Jdaniel98/smart-wall-socket/hardware/mech/renders/enclosure_v0.1_section.png

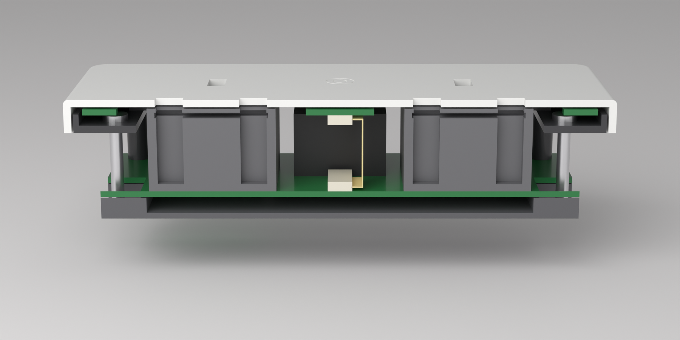
hardware/mech/renders/enclosure_v0.1_section.png
