Jdaniel98/smart-wall-socket/hardware/mech/concept/2_exploded.png

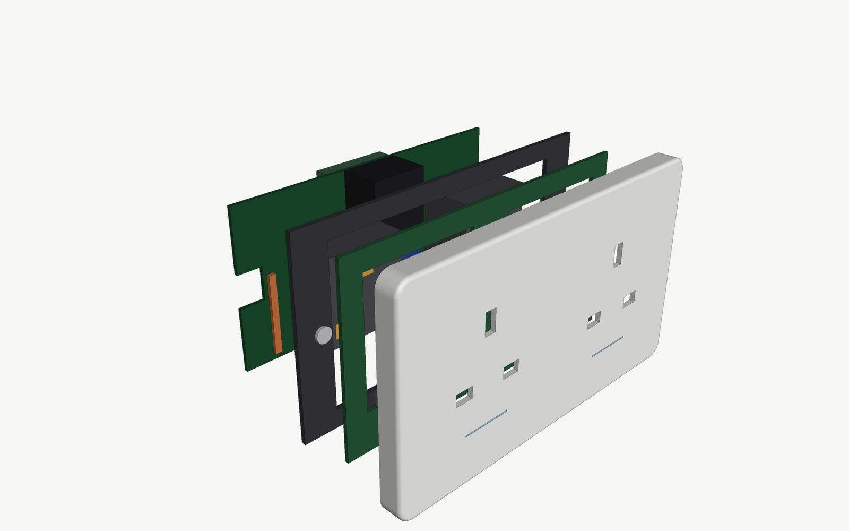
hardware/mech/concept/2_exploded.png
