Jdaniel98/smart-wall-socket/hardware/mech/concept/3_in_box.png

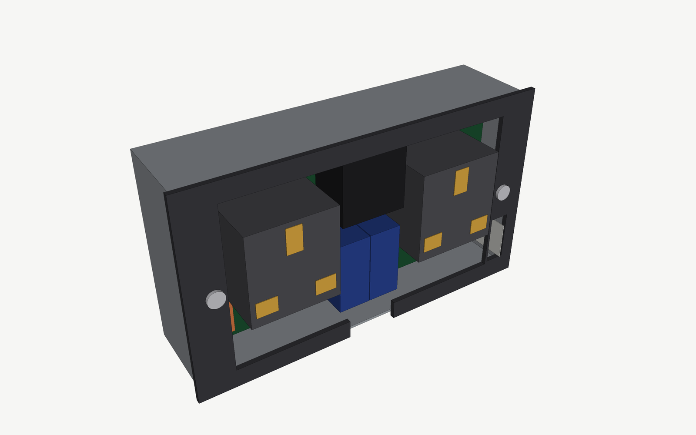
hardware/mech/concept/3_in_box.png
