Jdaniel98/smart-wall-socket/hardware/mech/concept/4_back.png

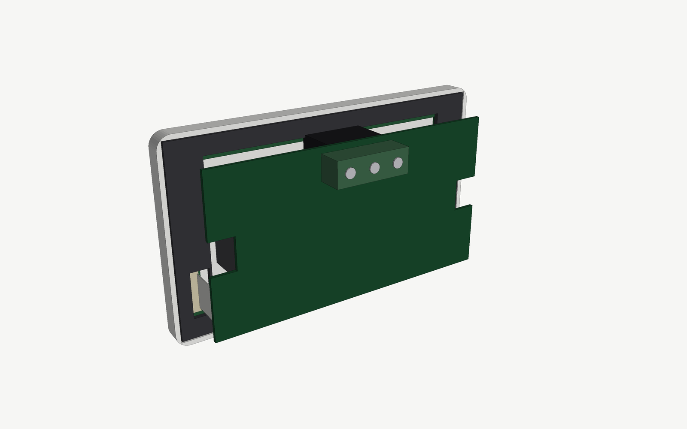
hardware/mech/concept/4_back.png
