Jdaniel98/smart-wall-socket/hardware/mech/concept/5_exploded_cycles.png

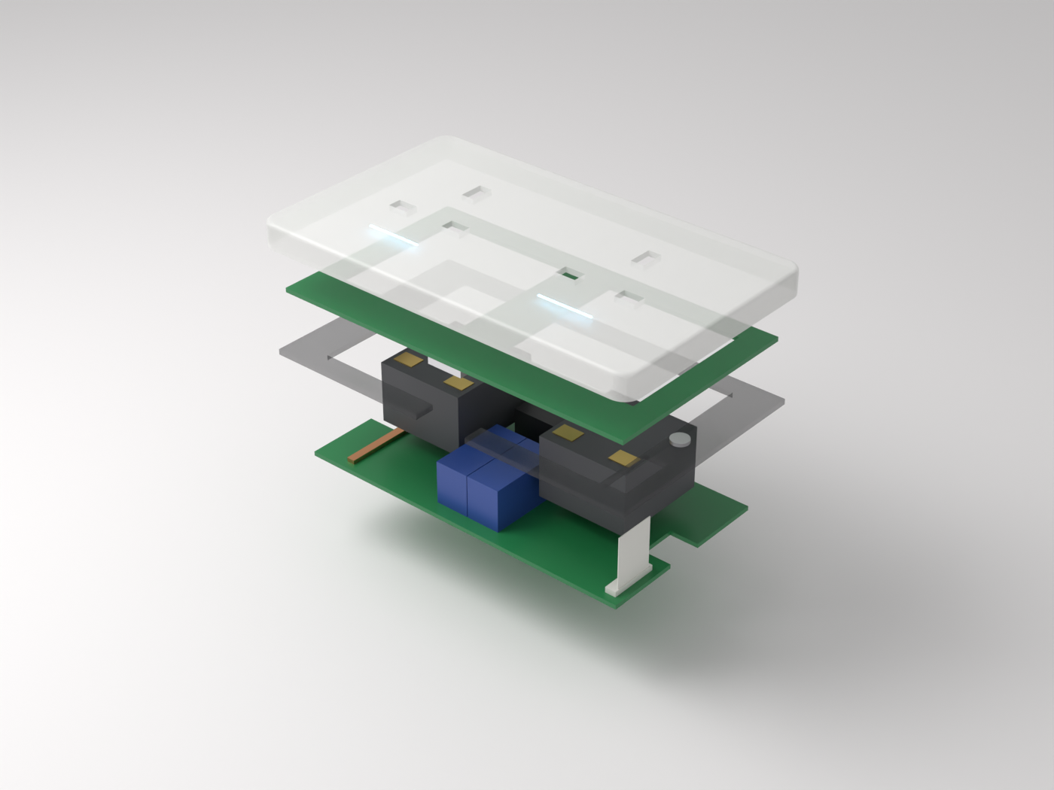
hardware/mech/concept/5_exploded_cycles.png
