Jdaniel98/smart-wall-socket/hardware/mech/concept/realistic/board.png

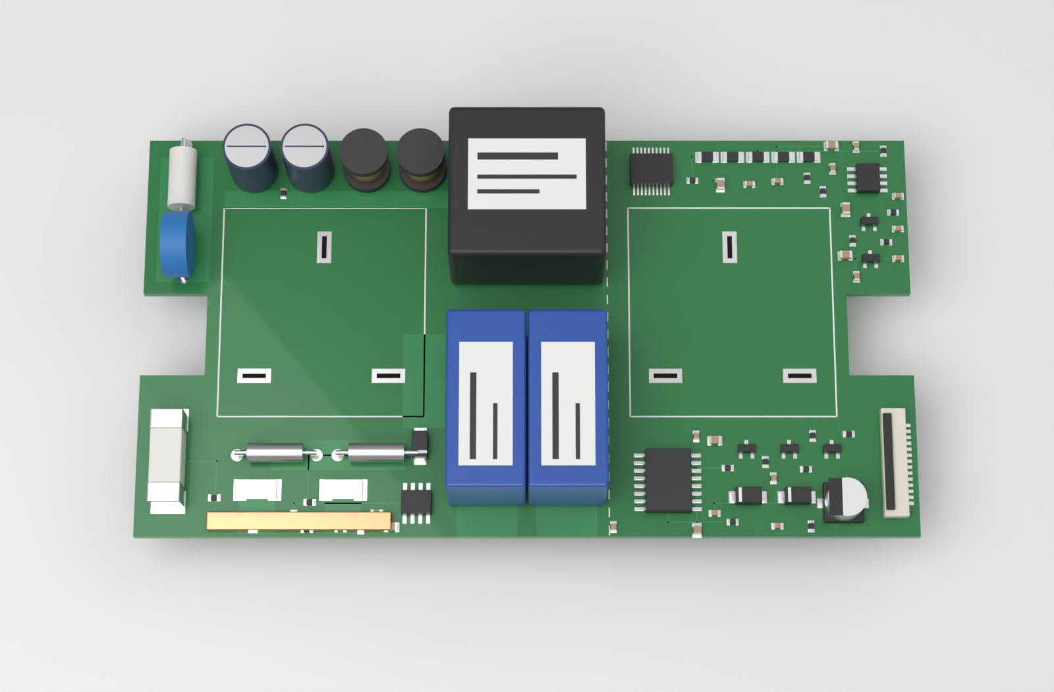
hardware/mech/concept/realistic/board.png
