Jdaniel98/smart-wall-socket/hardware/mech/concept/realistic/exploded.png

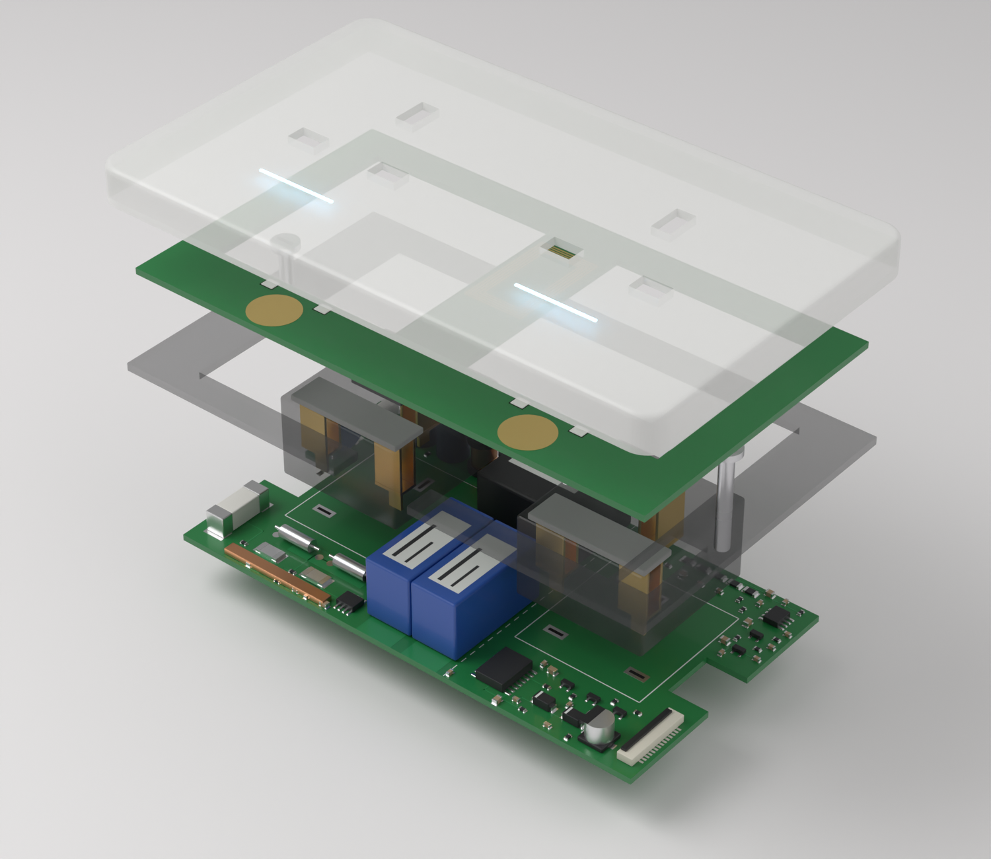
hardware/mech/concept/realistic/exploded.png
