Jdaniel98/smart-wall-socket/hardware/mech/concept/realistic/lineart.png

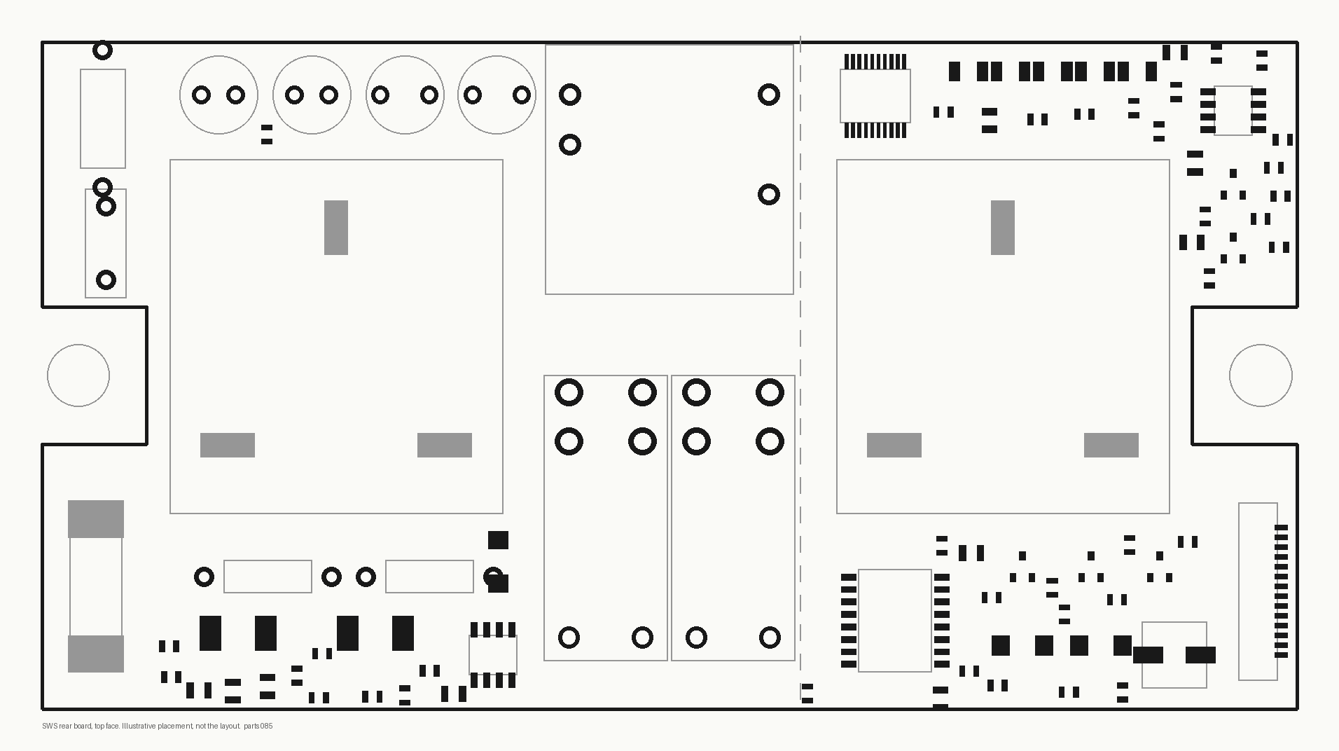
hardware/mech/concept/realistic/lineart.png
