Jdaniel98/smart-wall-socket/hardware/mech/renders/enclosure_v0.1_rear.png

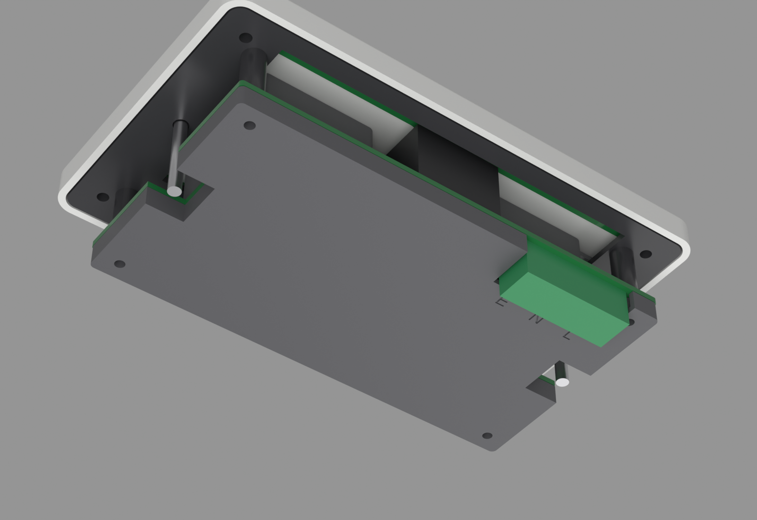
hardware/mech/renders/enclosure_v0.1_rear.png
