Jdaniel98/smart-wall-socket/hardware/mech/renders/outline_v0.1_front.png

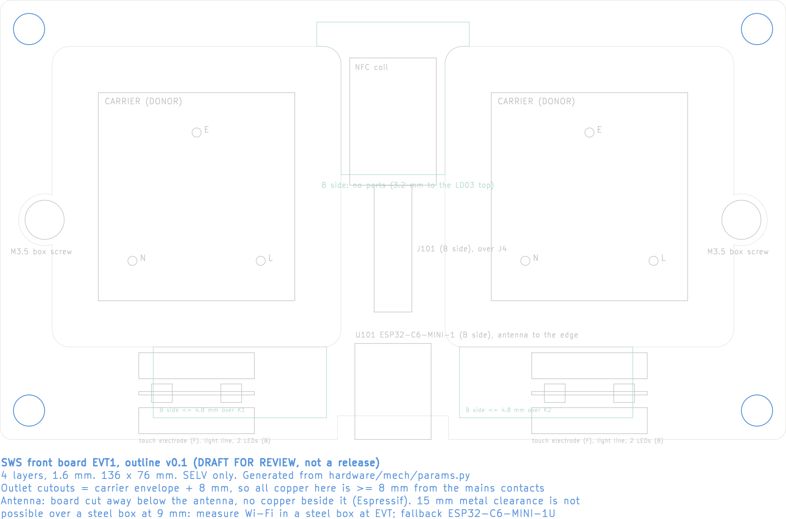
hardware/mech/renders/outline_v0.1_front.png
