Jdaniel98/smart-wall-socket/hardware/evt1/front/sws-front-bom-jlcpcb.csv

Comment | Designator | Footprint | LCSC Part #
22u 10V | C101,C104,C105 | C_0805_2012Metric | C45783
10u 10V | C102,C106,C118 | C_0805_2012Metric | C15850
100n | C107,C109,C110,C112,C114,C116,C117,C119,C120,C121,C122 | C_0603_1608Metric | C14663
1u | C108 | C_0603_1608Metric | C15849
10n C0G | C111,C113 | C_0603_1608Metric | C76599
FPC 14P 1.0mm bottom contact | J101 | TE_1-84952-4_1x14-1MP_P1.0mm_Horizontal | C574848
2.2uH 1.65A 45mR shielded | L101 | L_Bourns-SRN4018 | C340367
AO3401A | Q101 | SOT-23 | C15127
2N7002 | Q102 | SOT-23 | C8545
453k 1% | R101 | R_0603_1608Metric | C667826
100k 1% | R102 | R_0603_1608Metric | C25803
10k | R103,R104,R105,R116 | R_0603_1608Metric | C25804
10k 0.1% | R106,R107 | R_0603_1608Metric | C328421
4.7k | R108,R111,R114,R115 | R_0603_1608Metric | C23162
0R | R110,R113 | R_0603_1608Metric | C21189
33R | R117 | R_0603_1608Metric | C23140
100k | R118,R119 | R_0603_1608Metric | C25803
+5V | TP101 | TestPoint_Pad_D1.5mm
+3V3 | TP102 | TestPoint_Pad_D1.5mm
GND | TP103 | TestPoint_Pad_D1.5mm
EN | TP104 | TestPoint_Pad_D1.5mm
BOOT | TP105 | TestPoint_Pad_D1.5mm
U0TXD | TP106 | TestPoint_Pad_D1.5mm
U0RXD | TP107 | TestPoint_Pad_D1.5mm
USB_D+ | TP108 | TestPoint_Pad_D1.5mm
USB_D- | TP109 | TestPoint_Pad_D1.5mm
TLV62569DBVR | U101 | SOT-23-5 | C141836
AT42QT1011-TSHR | U103,U104 | SOT-23-6 | C112956
NT3H2111W0FTTJ | U105 | TSSOP-8_3x3mm_P0.65mm | C2654884
SN74AHCT1G125DBVR | U106 | SOT-23-5 | C7484
