Jdaniel98/smart-wall-socket/hardware/evt1/rear/sws-rear-bom-jlcpcb.csv

Comment | Designator | Footprint | LCSC Part #
4.7u 450V 105C 12000h | C1,C23 | CP_Radial_D8.0mm_P3.50mm | C22391567
10u 25V | C2,C5,C22,C25 | C_0805_2012Metric | C15850
100n | C3,C4,C11,C13,C14,C16 | C_0603_1608Metric | C14663
33n X7R | C6,C7,C8,C9,C10 | C_0603_1608Metric | C21117
1u | C15,C17,C20,C21,C27 | C_0603_1608Metric | C15849
1u 25V | C18 | C_0805_2012Metric | C116352
150u 10V 105C low ESR | C19 | CP_Elec_6.3x5.8 | C264054
1u 16V | C24 | C_0603_1608Metric | C15849
100u 16V 105C | C26 | CP_Elec_6.3x5.8 | C128532
M7 1000V 1A | D1,D8,D10 | D_SMA | C95872
BZT52C5V1 | D2 | D_SOD-123 | C2117
BAS116 | D3 | SOT-23 | C48502
SMBJ7.0A | D4 | D_SMB | C669050
SS14 | D5,D6 | D_SMA | C2480
ES1J 600V 35ns | D9 | D_SMA | C412438
FPC 14P 1.0mm bottom contact | J4 | TE_1-84952-4_1x14-1MP_P1.0mm_Horizontal | C574848
1mH 0.36A | L1,L2 | L_Radial_D8.7mm_P5.00mm_Fastron_07HCP | C72626
AO3400A | Q1,Q2 | SOT-23 | C20917
12R 3W wirewound | R1 | R_Axial_DIN0617_L17.0mm_D6.0mm_P20.32mm_Horizontal
47R 2W fusible wirewound | R2 | R_Axial_DIN0617_L17.0mm_D6.0mm_P20.32mm_Horizontal
1k | R3,R4,R5,R6,R13 | R_0603_1608Metric | C21190
390k 1% 1206 500V | R7,R8,R9,R10,R11 | R_1206_3216Metric | C307946
470R 1% | R12 | R_0603_1608Metric | C23179
10k | R14,R25,R26,R31,R32 | R_0603_1608Metric | C25804
2M VR37 3.5kV | R15,R16,R18,R19 | R_Axial_DIN0411_L9.9mm_D3.6mm_P12.70mm_Horizontal
47k 1% | R17,R20 | R_0603_1608Metric | C25819
470k 1% | R21 | R_0603_1608Metric | C23178
182k 1% | R22 | R_0603_1608Metric | C22894
100k 1% | R23 | R_0603_1608Metric | C25803
49.9k 1% | R24 | R_0603_1608Metric | C23184
100R | R27,R29 | R_0603_1608Metric | C22775
100k | R28,R30 | R_0603_1608Metric | C25803
3.09k 1% | R35 | R_0603_1608Metric | C843947
2.49k 0.5% | R36 | R_0603_1608Metric | C407609
1m 1% 5W metal element | RS1,RS2 | R_2512_6332Metric | C4175647
MOV 561K 10mm | RV1 | RV_Disc_D12mm_W4.2mm_P7.5mm | C3263770
10k B3950 1% | TH1,TH2 | R_0603_1608Metric | C47118797
LNK3204D | U1 | PowerIntegrations_SO-8C
BL0939 | U2 | SSOP-20_3.9x8.7mm_P0.635mm | C2841044
SN74LVC1G32DBVR | U3 | SOT-23-5 | C10096
LMV393IDR | U4 | SOIC-8_3.9x4.9mm_P1.27mm | C7984
ISO7761DWR | U5 | SOIC-16W_7.5x10.3mm_P1.27mm | C2871529
XC6206P332MR | U6,U7 | SOT-23 | C5446
