Jdaniel98/smart-wall-socket/hardware/mech/out/assembly_evt1_v0.1.step

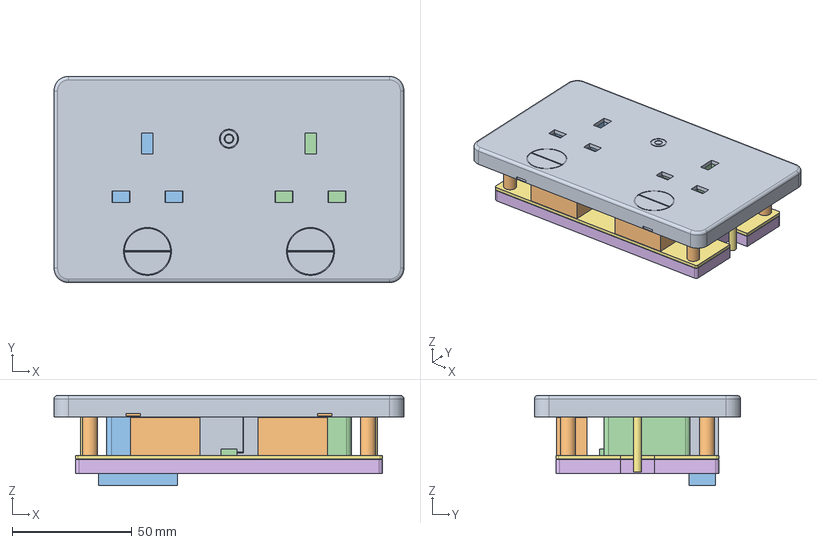
[picture p13: CAD file, 2026-11-11]
hardware/mech/out/assembly_evt1_v0.1.step
146.0 x 86.0 x 37.6 mm
