Jdaniel98/smart-wall-socket/hardware/mech/out/light_guide_right.step

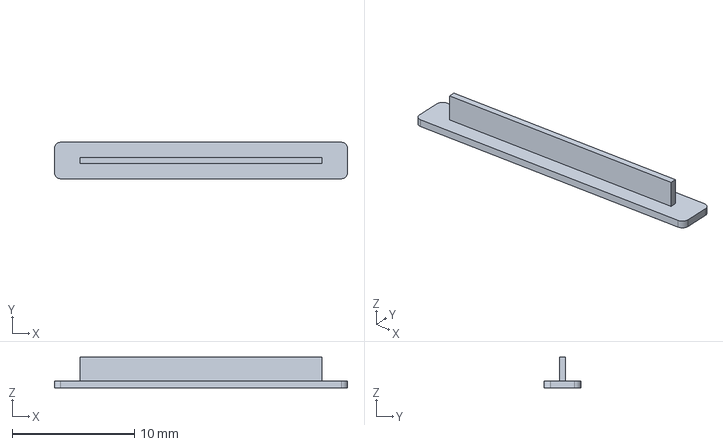
[picture p14: CAD file, 2026-11-11]
hardware/mech/out/light_guide_right.step
24.0 x 3.00 x 2.50 mm
