Jdaniel98/smart-wall-socket/hardware/mech/out/rear_cover.step

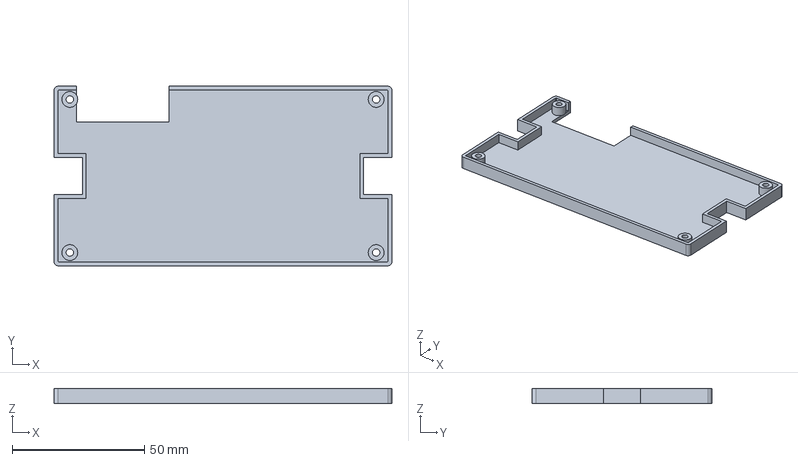
[picture p15: CAD file, 2026-11-11]
hardware/mech/out/rear_cover.step
128.0 x 68.0 x 5.80 mm
