Jdaniel98/smart-wall-socket/hardware/mech/out/carrier_right.step

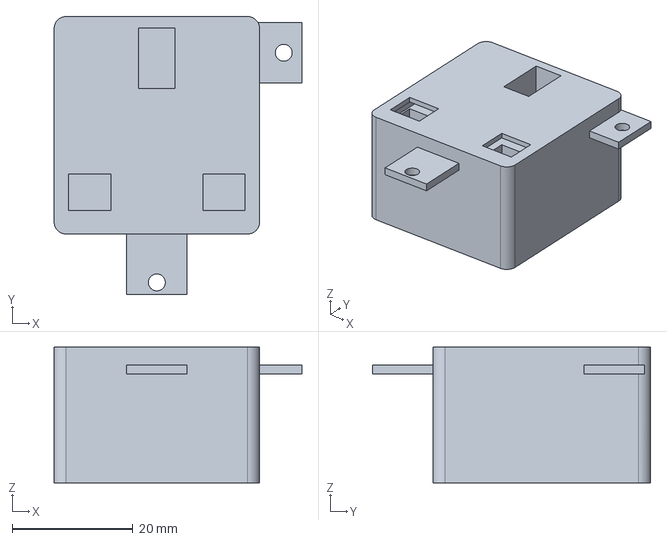
[picture p16: CAD file, 2026-11-11]
hardware/mech/out/carrier_right.step
41.0 x 46.0 x 22.5 mm
