Jdaniel98/smart-wall-socket/hardware/mech/out/faceplate.step

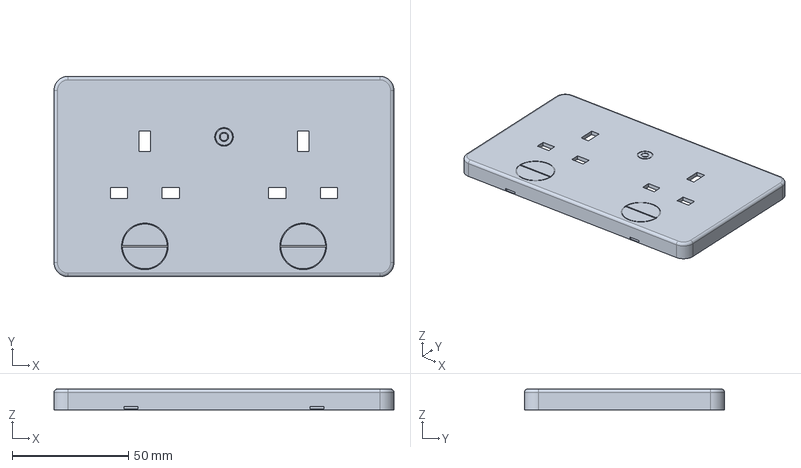
[picture p17: CAD file, 2026-11-11]
hardware/mech/out/faceplate.step
146.0 x 86.0 x 9.00 mm
