Jdaniel98/smart-wall-socket/hardware/mech/out/inner_frame.step

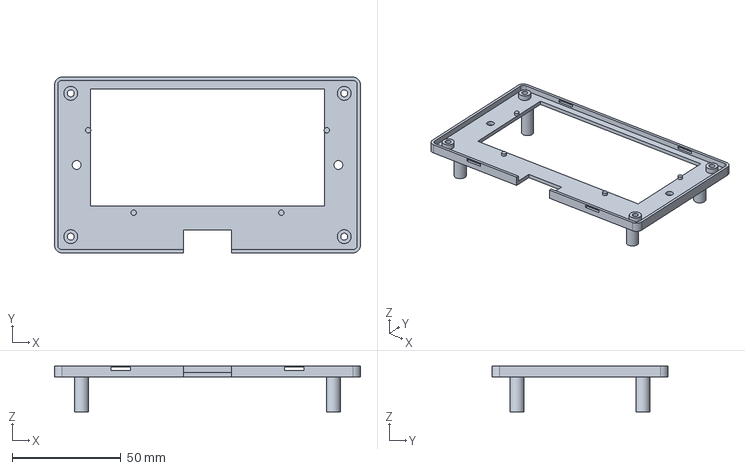
[picture p18: CAD file, 2026-11-11]
hardware/mech/out/inner_frame.step
141.0 x 81.0 x 21.0 mm
