Jdaniel98/smart-wall-socket/(list of files, cad)

Other CAD files:
hardware/mech/out/light_guide_left.step
hardware/mech/out/carrier_left.step
hardware/mech/out/carrier_left.stl
hardware/mech/out/carrier_right.stl
hardware/mech/out/faceplate.stl
hardware/mech/out/inner_frame.stl
hardware/mech/out/light_guide_left.stl
hardware/mech/out/light_guide_right.stl
hardware/mech/out/rear_cover.stl
