Jdaniel98/smart-wall-socket/hardware/mech/concept/1_assembled.png

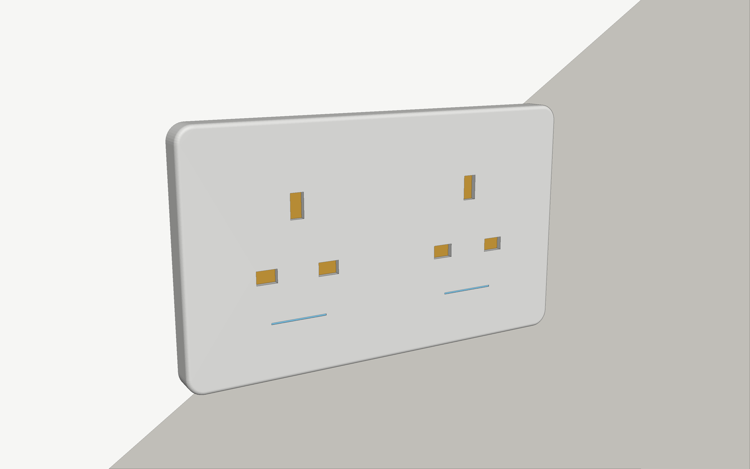
hardware/mech/concept/1_assembled.png
