Jdaniel98/smart-wall-socket/hardware/evt1/front/sws-front-schematic.pdf

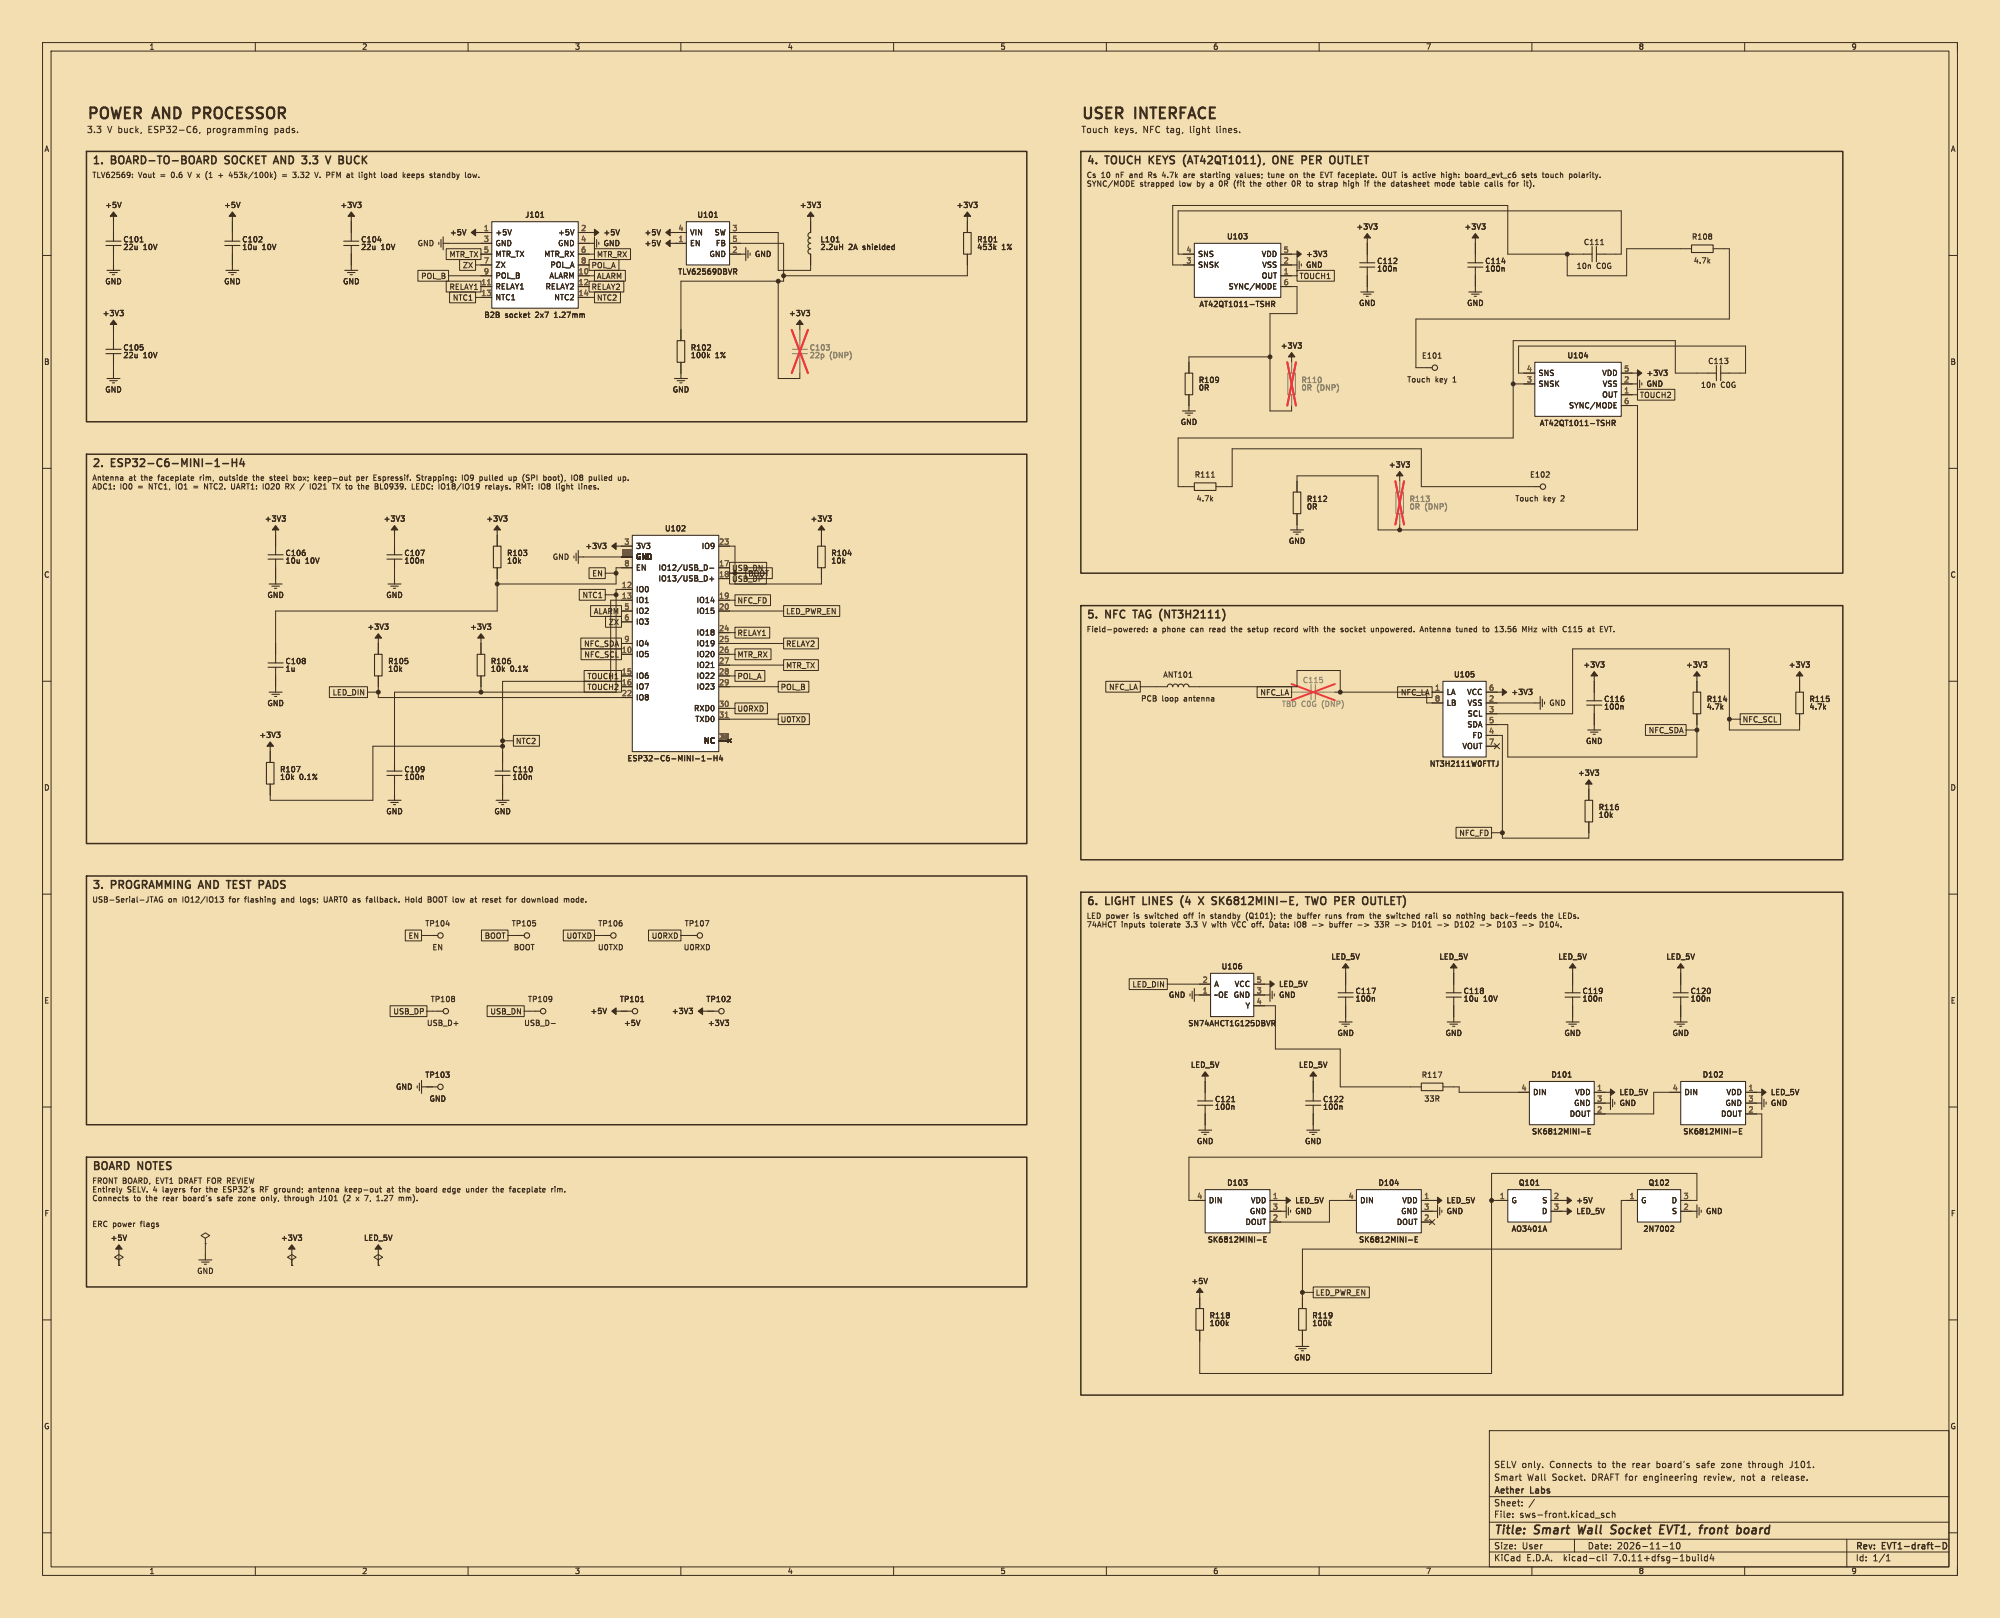
[picture p21: page 1]

Touch keys, NFC tag, light lines. USER INTERFACE

3. PROGRAMMING AND TEST PADS

BOARD NOTES
FRONT BOARD, EVT1 DRAFT FOR REVIEW

VDD 1 DOUT 2 GND 3 DIN 4

Id: 1/1 Title: Smart Wall Socket EVT1, front board
