Jdaniel98/smart-wall-socket/hardware/evt1/rear/sws-rear-schematic.pdf

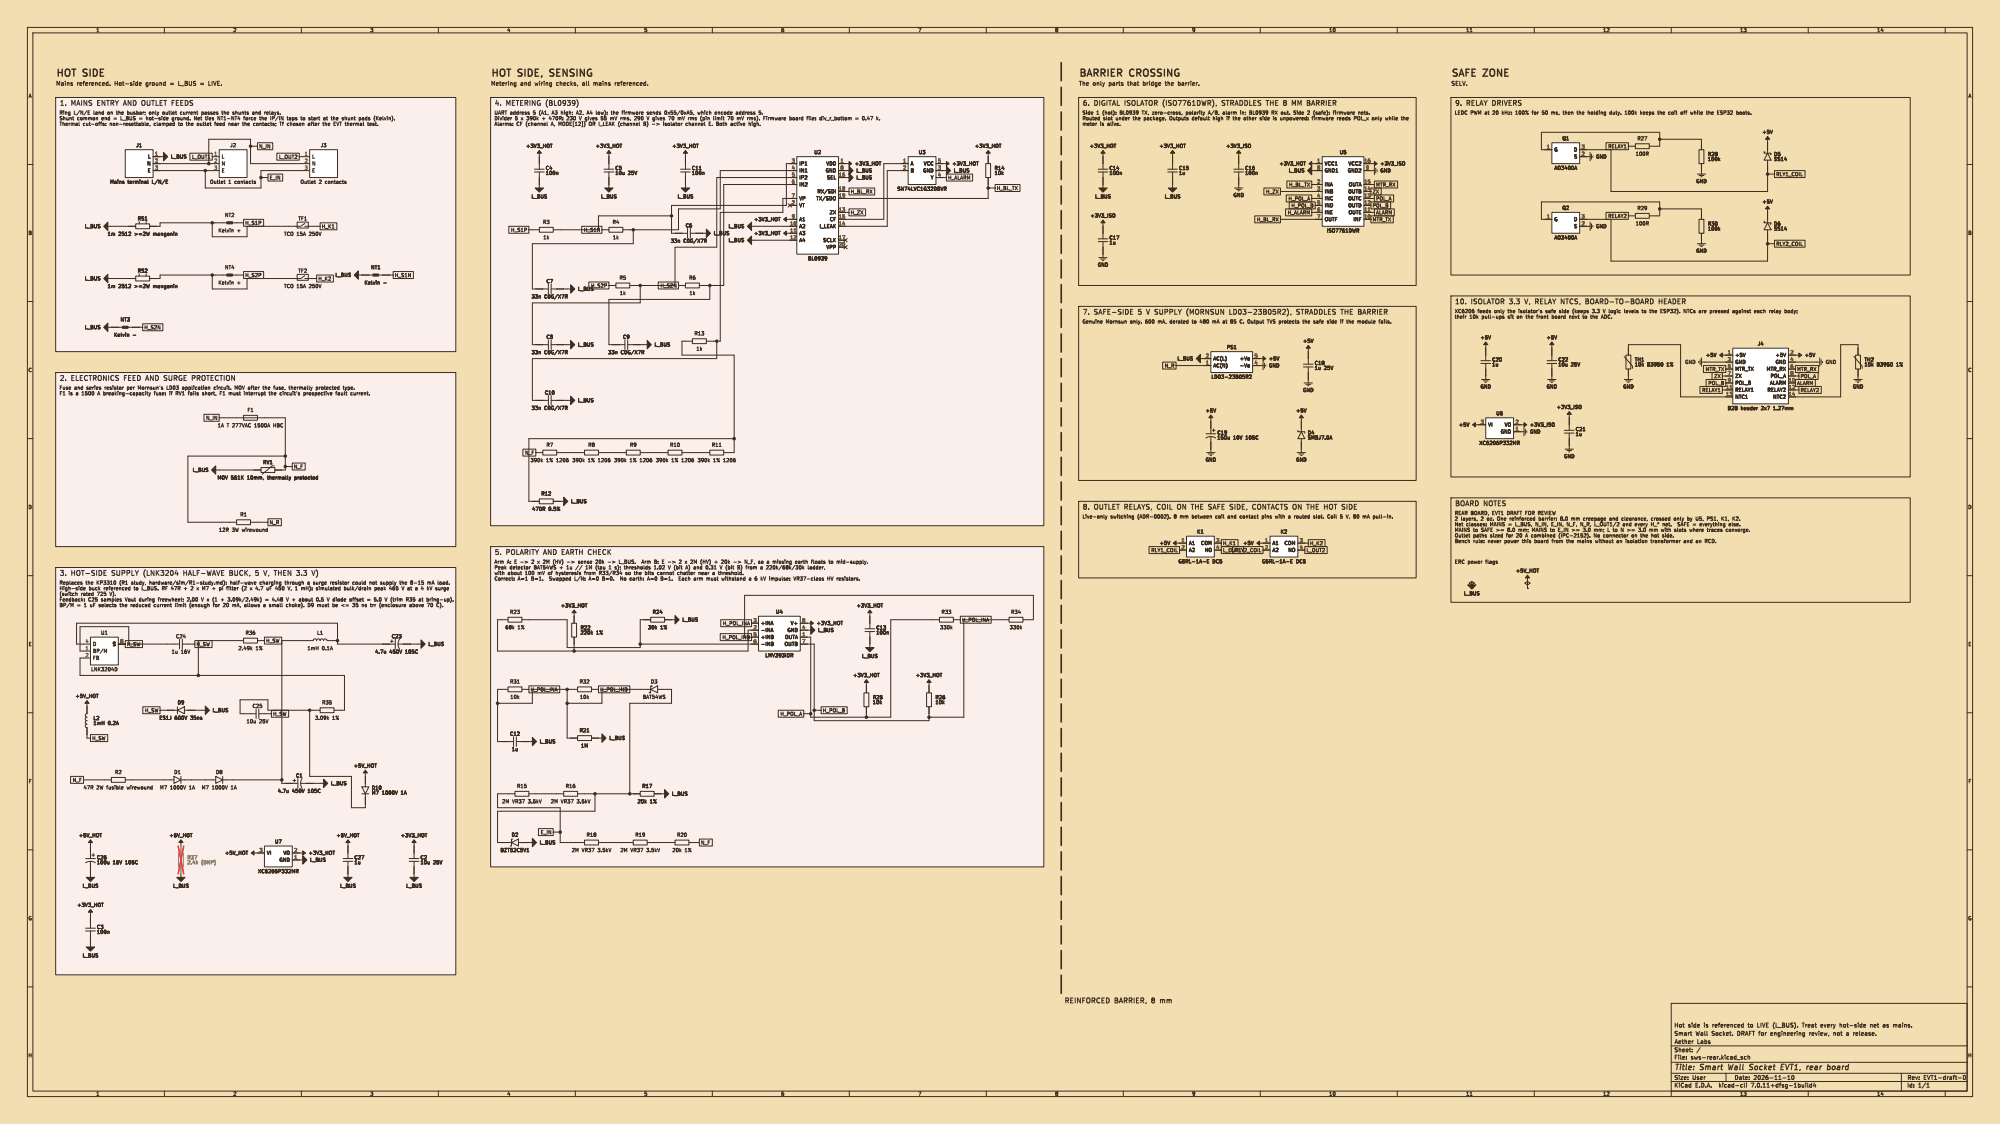
[picture p22: page 1]

HOT SIDE, SENSING
Metering and wiring checks, all mains referenced. 4. METERING (BL0939)

BARRIER CROSSING
The only parts that bridge the barrier.

8. OUTLET RELAYS, COIL ON THE SAFE SIDE, CONTACTS ON THE HOT SIDE

Id: 1/1 Title: Smart Wall Socket EVT1, rear board
