Jdaniel98/smart-wall-socket/hardware/evt1/front/sws-front.kicad_sch

## KiCad design hardware/evt1/front/sws-front.kicad_sch (2026-11-11)

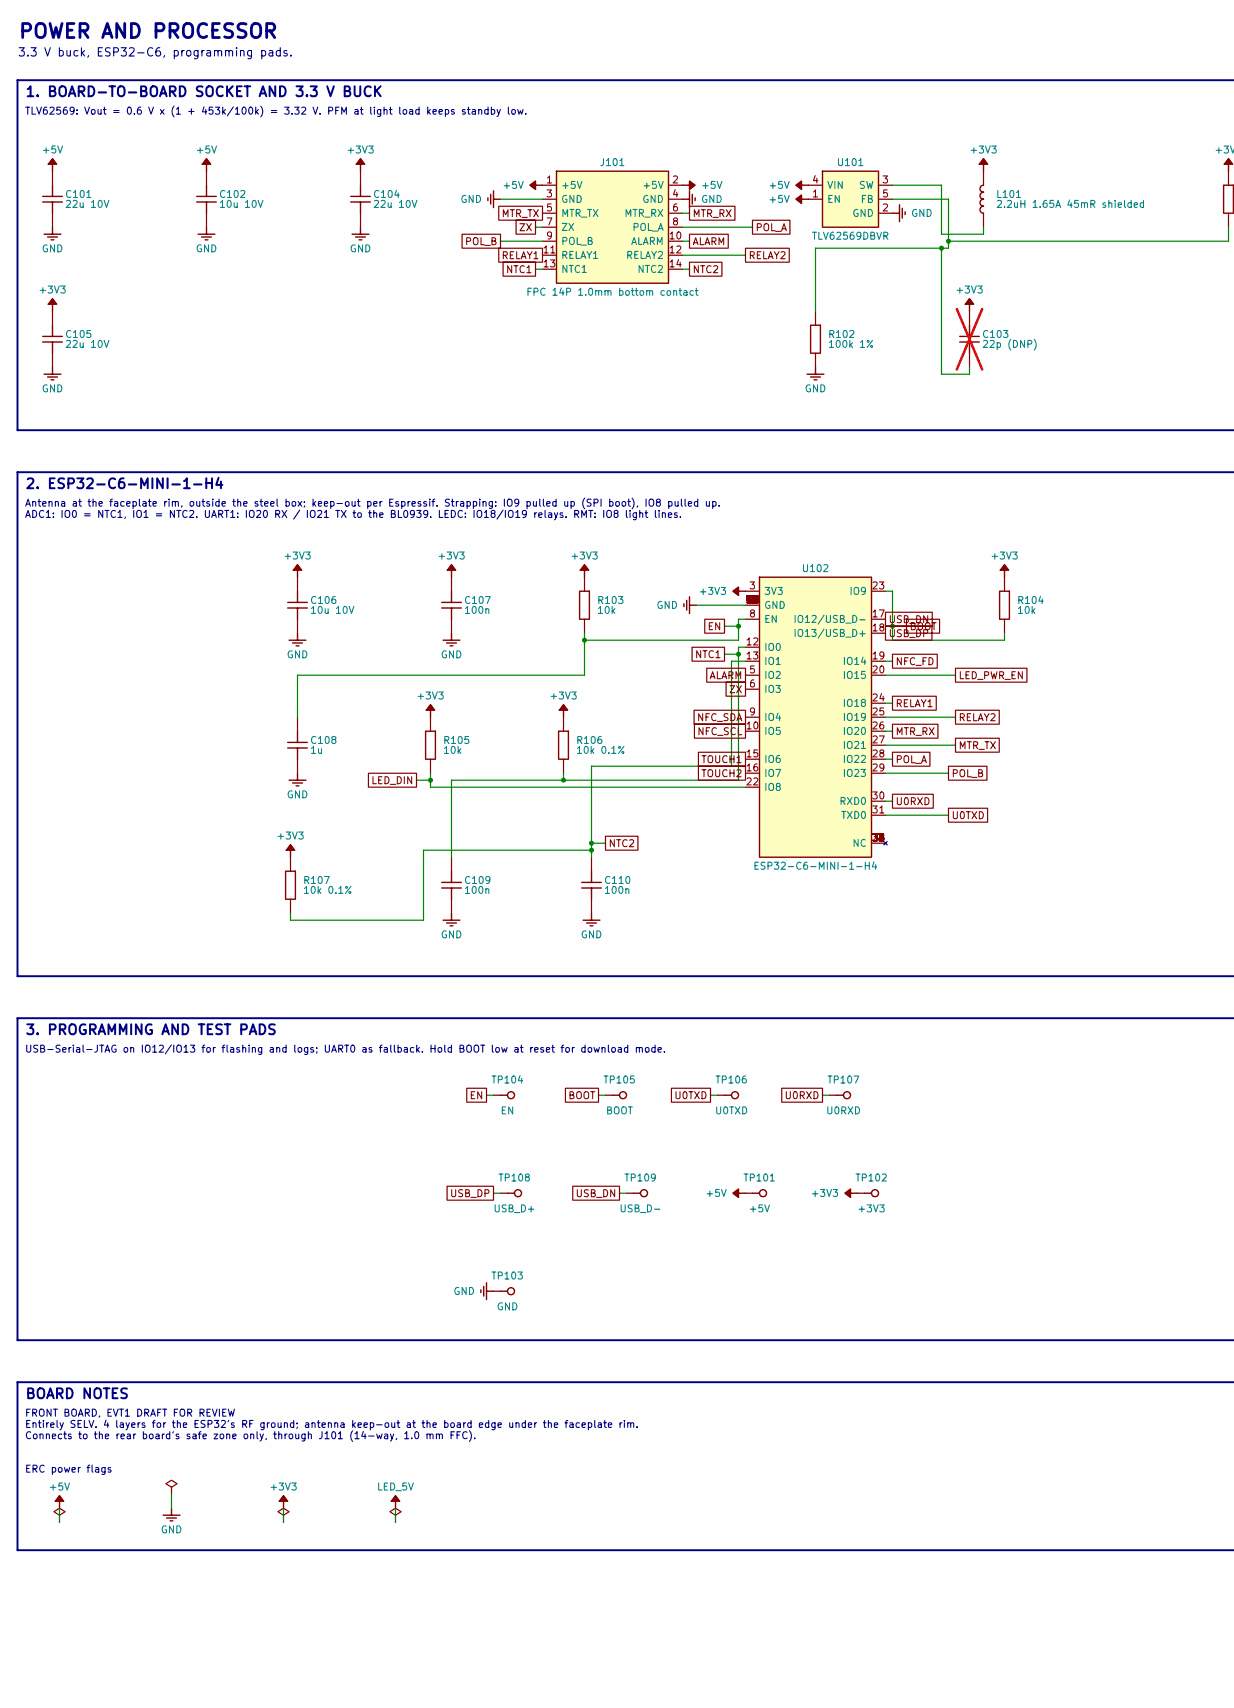
[picture p23: schematic sws-front.kicad_sch, part in row 1, column 1]

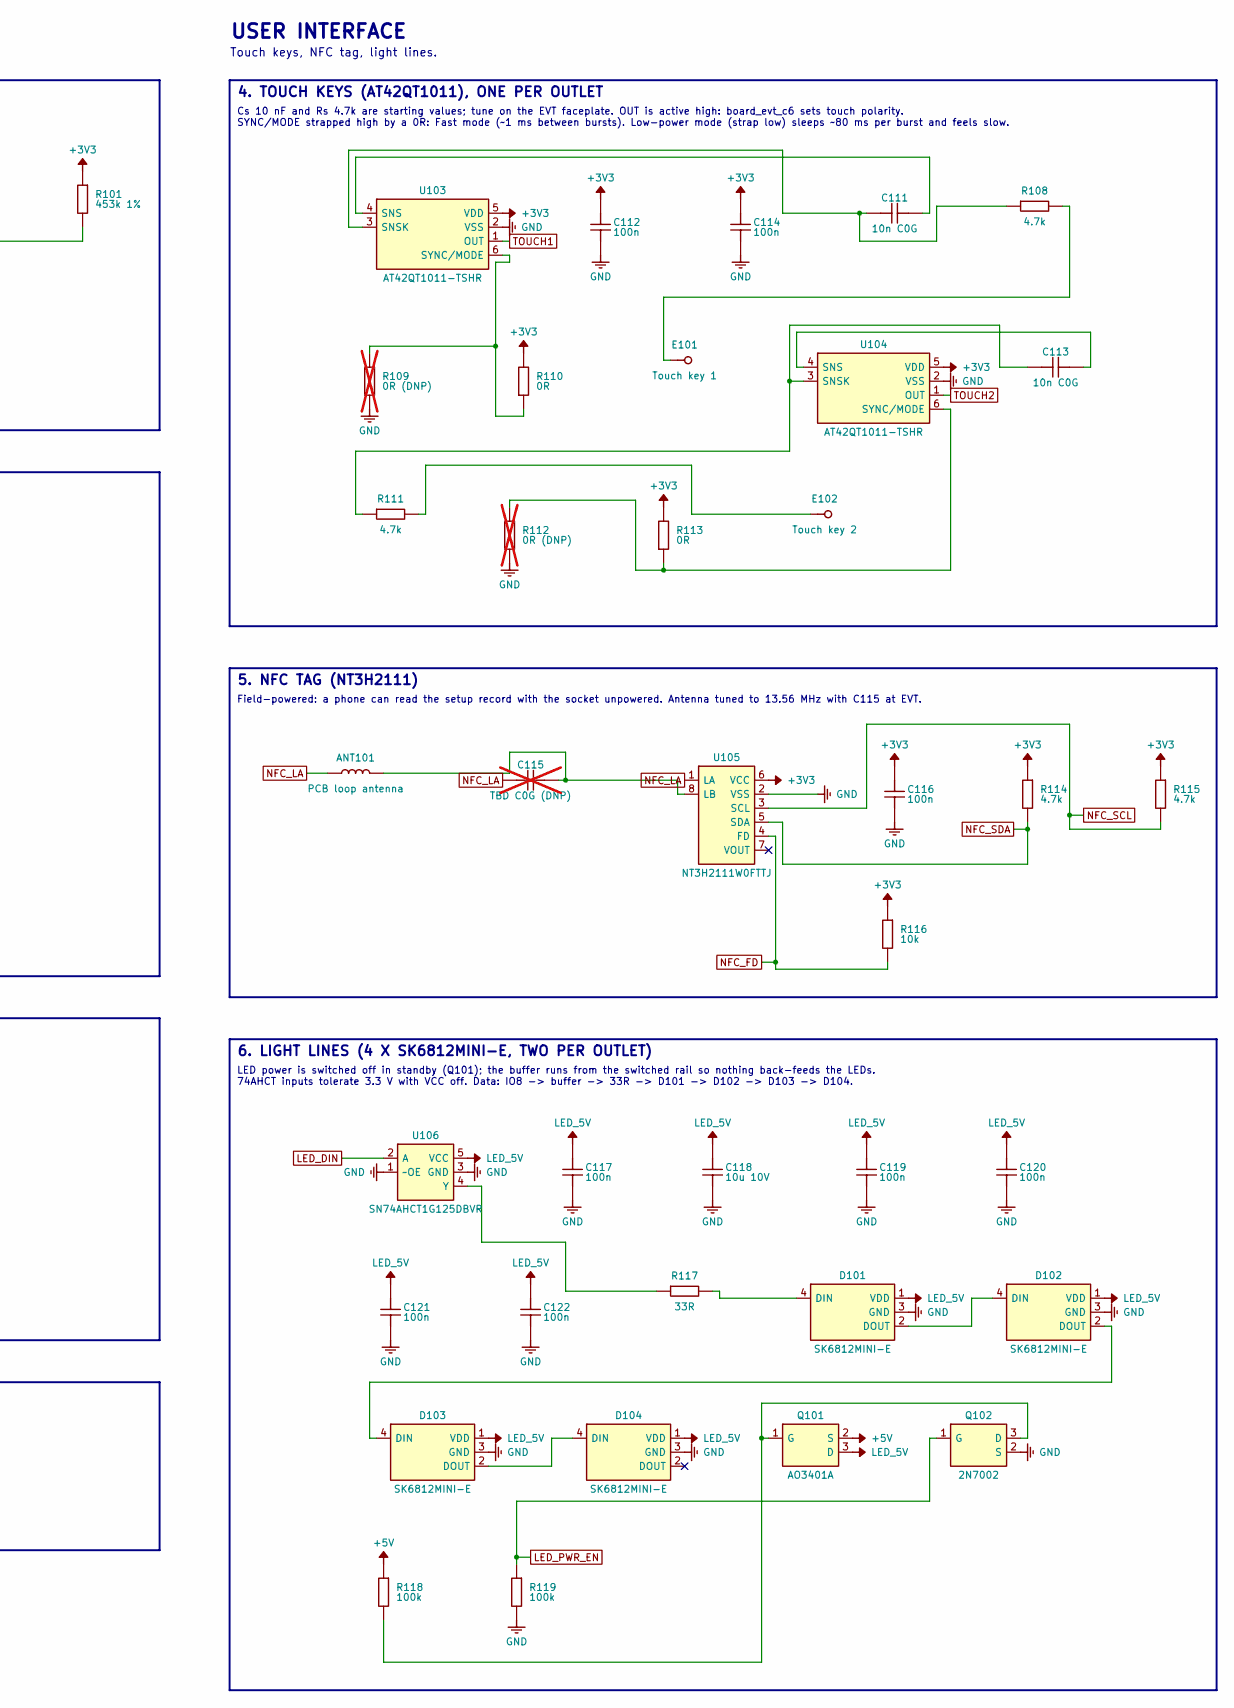
[picture p24: schematic sws-front.kicad_sch, part in row 1, column 2]

Parts:
ANT101: PCB loop antenna; NFC_Antenna_PCB_25x15
C101, C104, C105: 22u 10V; C_0805_2012Metric; LCSC C45783
C102, C106, C118: 10u 10V; C_0805_2012Metric; LCSC C15850
C103: 22p (DNP); C_0603_1608Metric; LCSC C1653; not fitted
C107, C109, C110, C112, C114, C116, C117, C119, C120, C121, C122: 100n; C_0603_1608Metric; LCSC C14663
C108: 1u; C_0603_1608Metric; LCSC C15849
C111, C113: 10n C0G; C_0603_1608Metric; MPN C1608C0G1H103JT000N; LCSC C76599
C115: TBD C0G (DNP); C_0603_1608Metric; not fitted
D101, D102, D103, D104: SK6812MINI-E; LED_SK6812MINI-E_Reverse; MPN SK6812MINI-E; LCSC C5149201
E101: Touch key 1; TouchPad_12mm
E102: Touch key 2; TouchPad_12mm
J101: FPC 14P 1.0mm bottom contact; TE_1-84952-4_1x14-1MP_P1.0mm_Horizontal; MPN 1-84952-4; LCSC C574848
L101: 2.2uH 1.65A 45mR shielded; L_Bourns-SRN4018; MPN YNR4018-2R2M; LCSC C340367
Q101: AO3401A; SOT-23; MPN AO3401A; LCSC C15127
Q102: 2N7002; SOT-23; MPN 2N7002; LCSC C8545
R101: 453k 1%; R_0603_1608Metric; MPN TD03G4533FT; LCSC C667826
R102: 100k 1%; R_0603_1608Metric; LCSC C25803
R103, R104, R105, R116: 10k; R_0603_1608Metric; LCSC C25804
R106, R107: 10k 0.1%; R_0603_1608Metric; MPN PTFR0603B10K0P9; LCSC C328421
R108, R111, R114, R115: 4.7k; R_0603_1608Metric; LCSC C23162
R109, R112: 0R (DNP); R_0603_1608Metric; LCSC C21189; not fitted
R110, R113: 0R; R_0603_1608Metric; LCSC C21189
R117: 33R; R_0603_1608Metric; MPN 0603WAF330JT5E; LCSC C23140
R118, R119: 100k; R_0603_1608Metric; LCSC C25803
TP101: +5V; TestPoint_Pad_D1.5mm
TP102: +3V3; TestPoint_Pad_D1.5mm
TP103: GND; TestPoint_Pad_D1.5mm
TP104: EN; TestPoint_Pad_D1.5mm
TP105: BOOT; TestPoint_Pad_D1.5mm
TP106: U0TXD; TestPoint_Pad_D1.5mm
TP107: U0RXD; TestPoint_Pad_D1.5mm
TP108: USB_D+; TestPoint_Pad_D1.5mm
TP109: USB_D-; TestPoint_Pad_D1.5mm
U101: TLV62569DBVR; SOT-23-5; MPN TLV62569DBVR; LCSC C141836
U102: ESP32-C6-MINI-1-H4; ESP32-C6-MINI-1; MPN ESP32-C6-MINI-1-H4; LCSC C6553337
U103, U104: AT42QT1011-TSHR; SOT-23-6; MPN AT42QT1011-TSHR; LCSC C112956
U105: NT3H2111W0FTTJ; TSSOP-8_3x3mm_P0.65mm; MPN NT3H2111W0FTTJ; LCSC C2654884
U106: SN74AHCT1G125DBVR; SOT-23-5; MPN SN74AHCT1G125DBVR; LCSC C7484

Connections:
+3V3: C103.1, C104.1, C105.1, C106.1, C107.1, C112.1, C114.1, C116.1, L101.2, R101.1, R103.1, R104.1, R105.1, R106.1, R107.1, R110.2, R113.2, R114.1, R115.1, R116.1, TP102.1, U102.3 (3V3), U103.5 (VDD), U104.5 (VDD), U105.6 (VCC)
+5V: C101.1, C102.1, J101.1 (+5V), J101.2 (+5V), Q101.2 (S), R118.1, TP101.1, U101.1 (EN), U101.4 (VIN)
ALARM: J101.10 (ALARM), U102.5 (IO2)
BOOT: R104.2, TP105.1, U102.23 (IO9)
EN: C108.1, R103.2, TP104.1, U102.8 (EN)
GND: C101.2, C102.2, C104.2, C105.2, C106.2, C107.2, C108.2, C109.2, C110.2, C112.2, C114.2, C116.2, C117.2, C118.2, C119.2, C120.2, C121.2, C122.2, D101.3 (GND), D102.3 (GND), D103.3 (GND), D104.3 (GND), J101.3 (GND), J101.4 (GND), Q102.2 (S), R102.2, R109.2, R112.2, R119.2, TP103.1, U101.2 (GND), U102.1 (GND), U102.2 (GND), U102.11 (GND), U102.14 (GND), U102.36 (GND), U102.37 (GND), U102.38 (GND), U102.39 (GND), U102.40 (GND), U102.41 (GND), U102.42 (GND), U102.43 (GND), U102.44 (GND), U102.45 (GND), U102.46 (GND), U102.47 (GND), U102.48 (GND), U102.49 (GND), U102.50 (GND), U102.51 (GND), U102.52 (GND), U102.53 (GND), U103.2 (VSS), U104.2 (VSS), U105.2 (VSS), U106.1 (~OE), U106.3 (GND)
LED_5V: C117.1, C118.1, C119.1, C120.1, C121.1, C122.1, D101.1 (VDD), D102.1 (VDD), D103.1 (VDD), D104.1 (VDD), Q101.3 (D), U106.5 (VCC)
LED_DIN: R105.2, U102.22 (IO8), U106.2 (A)
LED_PWR_EN: Q102.1 (G), R119.1, U102.20 (IO15)
MTR_RX: J101.6 (MTR_RX), U102.26 (IO20)
MTR_TX: J101.5 (MTR_TX), U102.27 (IO21)
NFC_FD: R116.2, U102.19 (IO14), U105.4 (FD)
NFC_LA: ANT101.1, C115.1, U105.1 (LA)
NFC_SCL: R115.2, U102.10 (IO5), U105.3 (SCL)
NFC_SDA: R114.2, U102.9 (IO4), U105.5 (SDA)
NTC1: C109.1, J101.13 (NTC1), R106.2, U102.12 (IO0)
NTC2: C110.1, J101.14 (NTC2), R107.2, U102.13 (IO1)
unnamed: ANT101.2, C115.2, U105.8 (LB)
unnamed: C103.2, R101.2, R102.1, U101.5 (FB)
unnamed: C111.1, R108.1, U103.3 (SNSK)
unnamed: C111.2, U103.4 (SNS)
unnamed: C113.1, R111.1, U104.3 (SNSK)
unnamed: C113.2, U104.4 (SNS)
unnamed: D101.2 (DOUT), D102.4 (DIN)
unnamed: D101.4 (DIN), R117.2
unnamed: D102.2 (DOUT), D103.4 (DIN)
unnamed: D103.2 (DOUT), D104.4 (DIN)
unnamed: E101.1, R108.2
unnamed: E102.1, R111.2
unnamed: L101.1, U101.3 (SW)
unnamed: Q101.1 (G), Q102.3 (D), R118.2
unnamed: R109.1, R110.1, U103.6 (SYNC/MODE)
unnamed: R112.1, R113.1, U104.6 (SYNC/MODE)
unnamed: R117.1, U106.4 (Y)
unnamed: U102.4 (NC), U102.7 (NC), U102.21 (NC), U102.32 (NC), U102.33 (NC), U102.34 (NC), U102.35 (NC)
POL_A: J101.8 (POL_A), U102.28 (IO22)
POL_B: J101.9 (POL_B), U102.29 (IO23)
RELAY1: J101.11 (RELAY1), U102.24 (IO18)
RELAY2: J101.12 (RELAY2), U102.25 (IO19)
TOUCH1: U102.15 (IO6), U103.1 (OUT)
TOUCH2: U102.16 (IO7), U104.1 (OUT)
U0RXD: TP107.1, U102.30 (RXD0)
U0TXD: TP106.1, U102.31 (TXD0)
USB_DN: TP109.1, U102.17 (IO12/USB_D-)
USB_DP: TP108.1, U102.18 (IO13/USB_D+)
ZX: J101.7 (ZX), U102.6 (IO3)

Notes on the sheet:
POWER AND PROCESSOR
3.3 V buck, ESP32-C6, programming pads.
USER INTERFACE
Touch keys, NFC tag, light lines.
1. BOARD-TO-BOARD SOCKET AND 3.3 V BUCK
TLV62569: Vout = 0.6 V x (1 + 453k/100k) = 3.32 V. PFM at light load keeps standby low.
2. ESP32-C6-MINI-1-H4
Antenna at the faceplate rim, outside the steel box; keep-out per Espressif. Strapping: IO9 pulled up (SPI boot), IO8 pulled up. ADC1: IO0 = NTC1, IO1 = NTC2. UART1: IO20 RX / IO21 TX to the BL0939. LEDC: IO18/IO19 relays. RMT: IO8 light lines.
3. PROGRAMMING AND TEST PADS
USB-Serial-JTAG on IO12/IO13 for flashing and logs; UART0 as fallback. Hold BOOT low at reset for download mode.
4. TOUCH KEYS (AT42QT1011), ONE PER OUTLET
Cs 10 nF and Rs 4.7k are starting values; tune on the EVT faceplate. OUT is active high: board_evt_c6 sets touch polarity. SYNC/MODE strapped high by a 0R: Fast mode (~1 ms between bursts). Low-power mode (strap low) sleeps ~80 ms per burst and feels slow.
5. NFC TAG (NT3H2111)
Field-powered: a phone can read the setup record with the socket unpowered. Antenna tuned to 13.56 MHz with C115 at EVT.
6. LIGHT LINES (4 X SK6812MINI-E, TWO PER OUTLET)
LED power is switched off in standby (Q101); the buffer runs from the switched rail so nothing back-feeds the LEDs. 74AHCT inputs tolerate 3.3 V with VCC off. Data: IO8 -> buffer -> 33R -> D101 -> D102 -> D103 -> D104.
BOARD NOTES
FRONT BOARD, EVT1 DRAFT FOR REVIEW Entirely SELV. 4 layers for the ESP32's RF ground; antenna keep-out at the board edge under the faceplate rim. Connects to the rear board's safe zone only, through J101 (14-way, 1.0 mm FFC).
ERC power flags
