Jdaniel98/smart-wall-socket/hardware/evt1/rear/sws-rear.kicad_sch

## KiCad design hardware/evt1/rear/sws-rear.kicad_sch (2026-11-11)

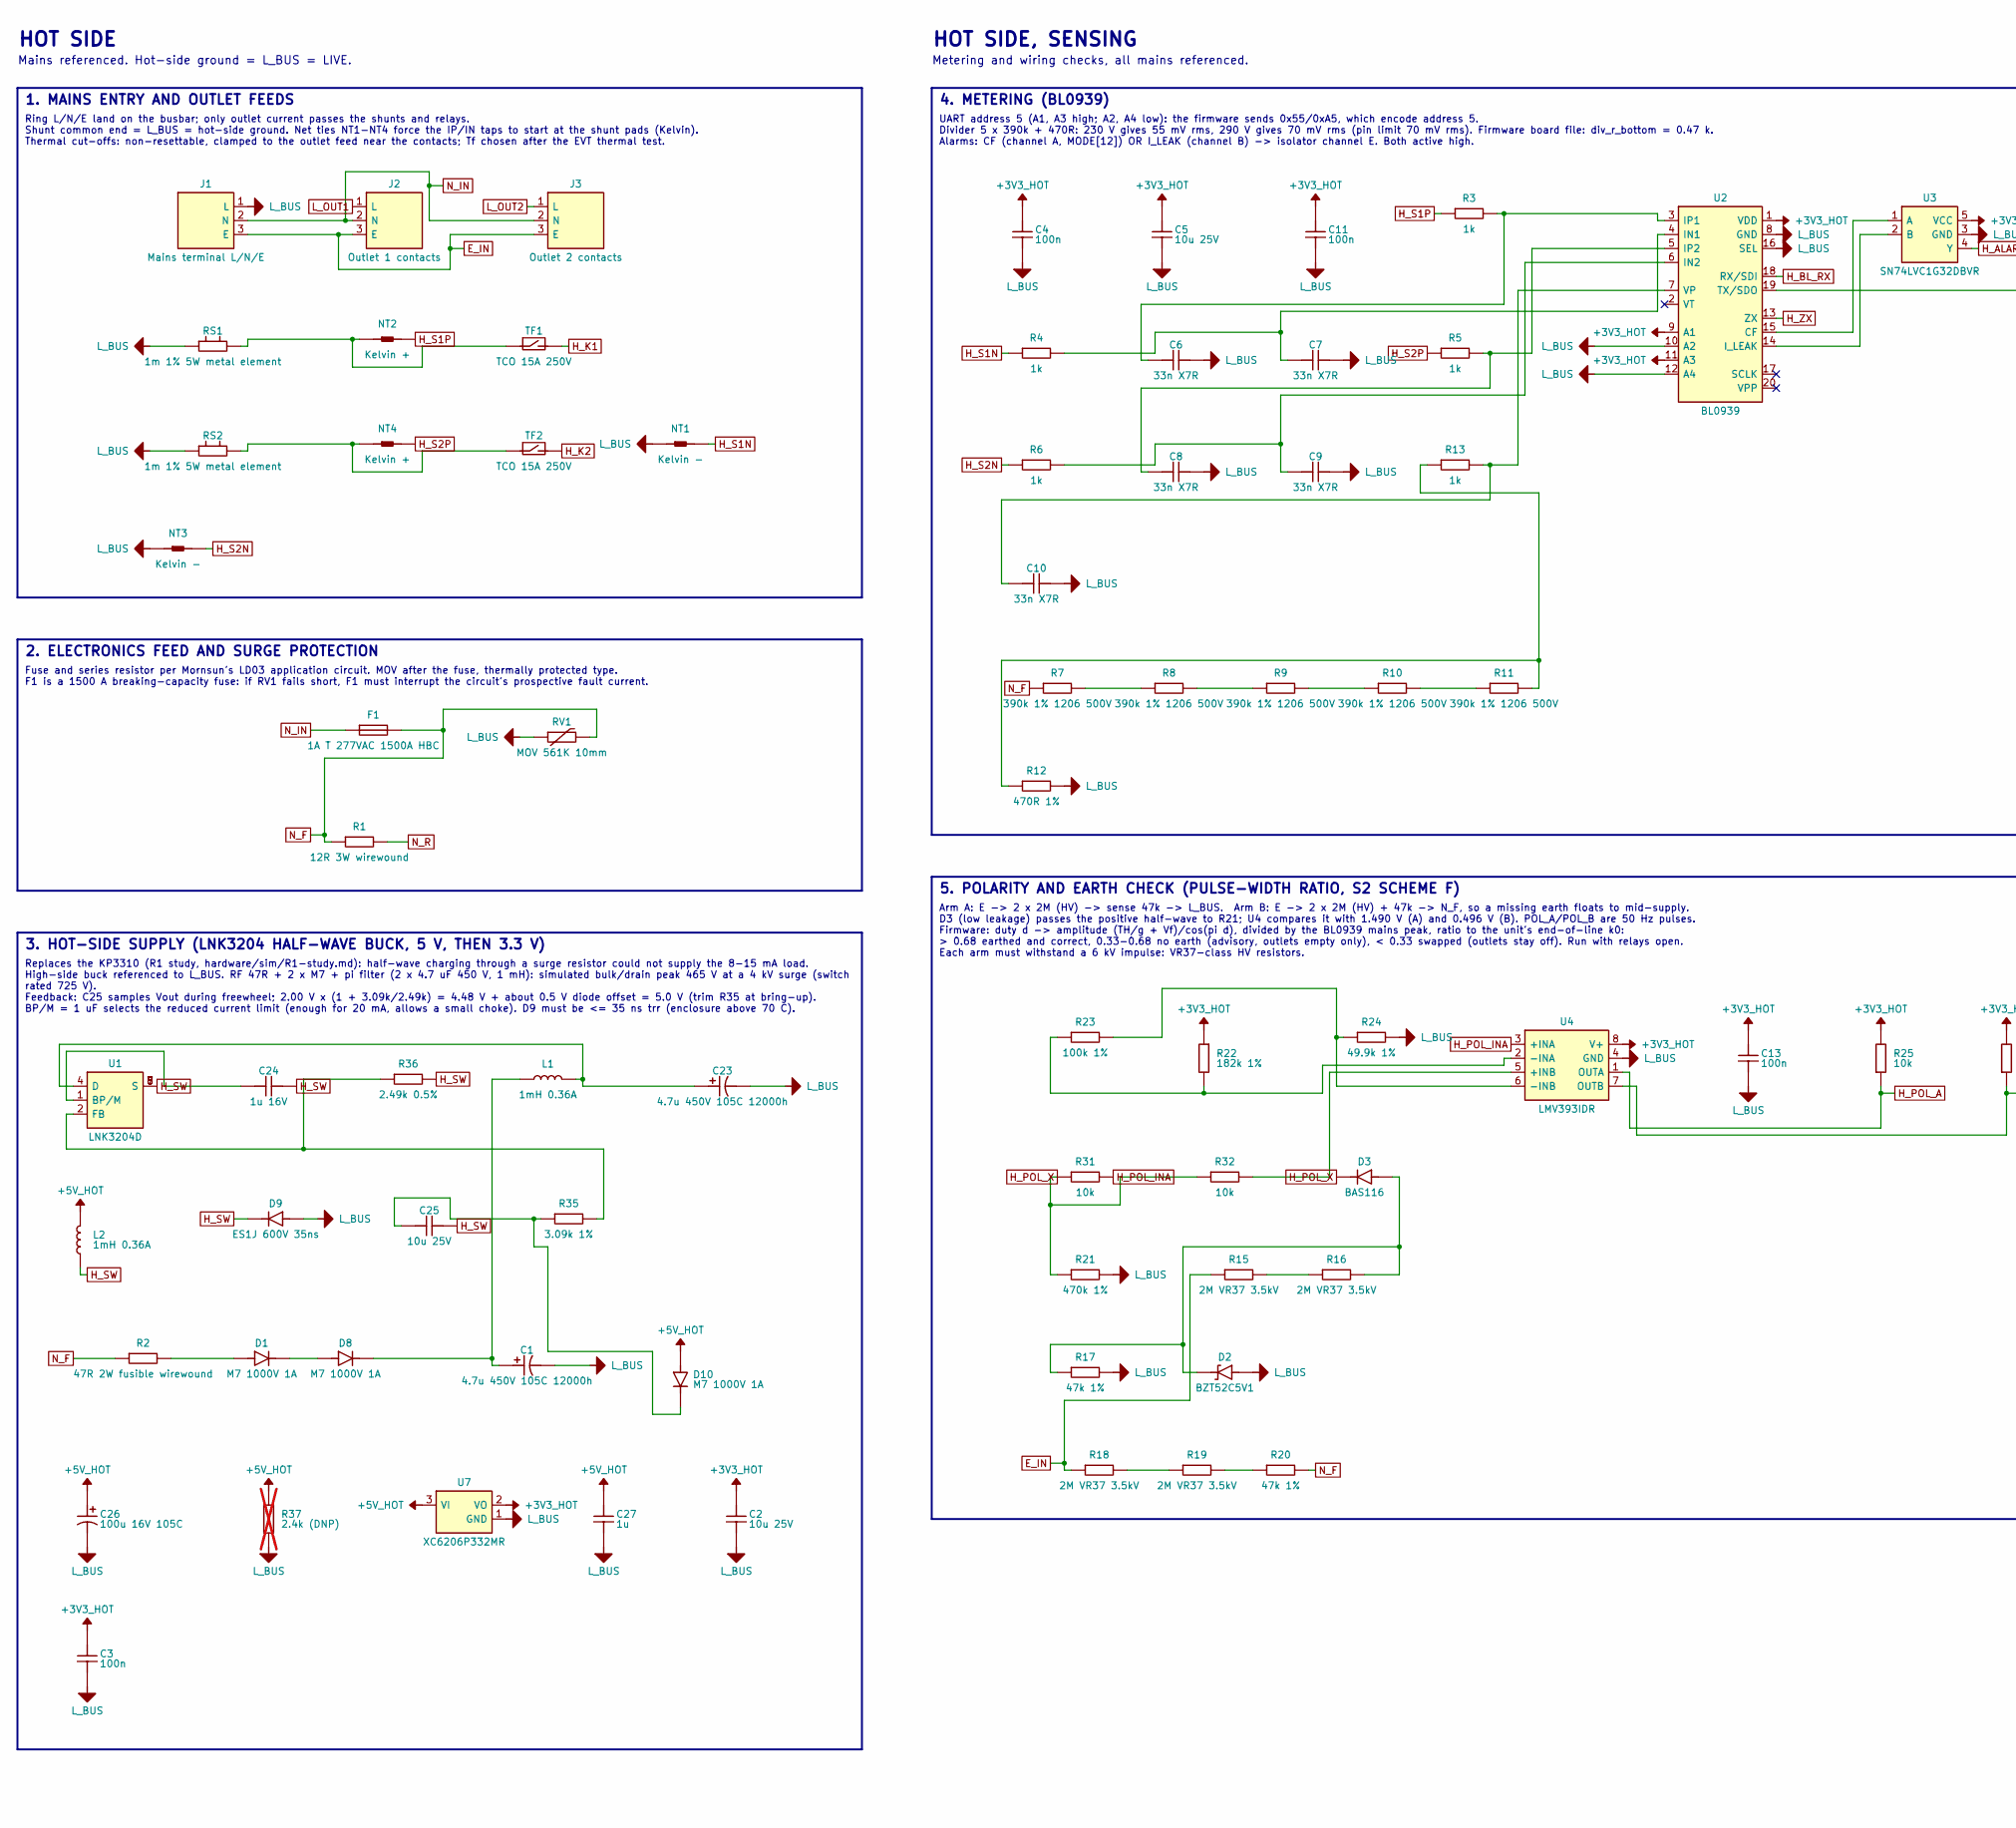
[picture p25: schematic sws-rear.kicad_sch, part in row 1, column 1]

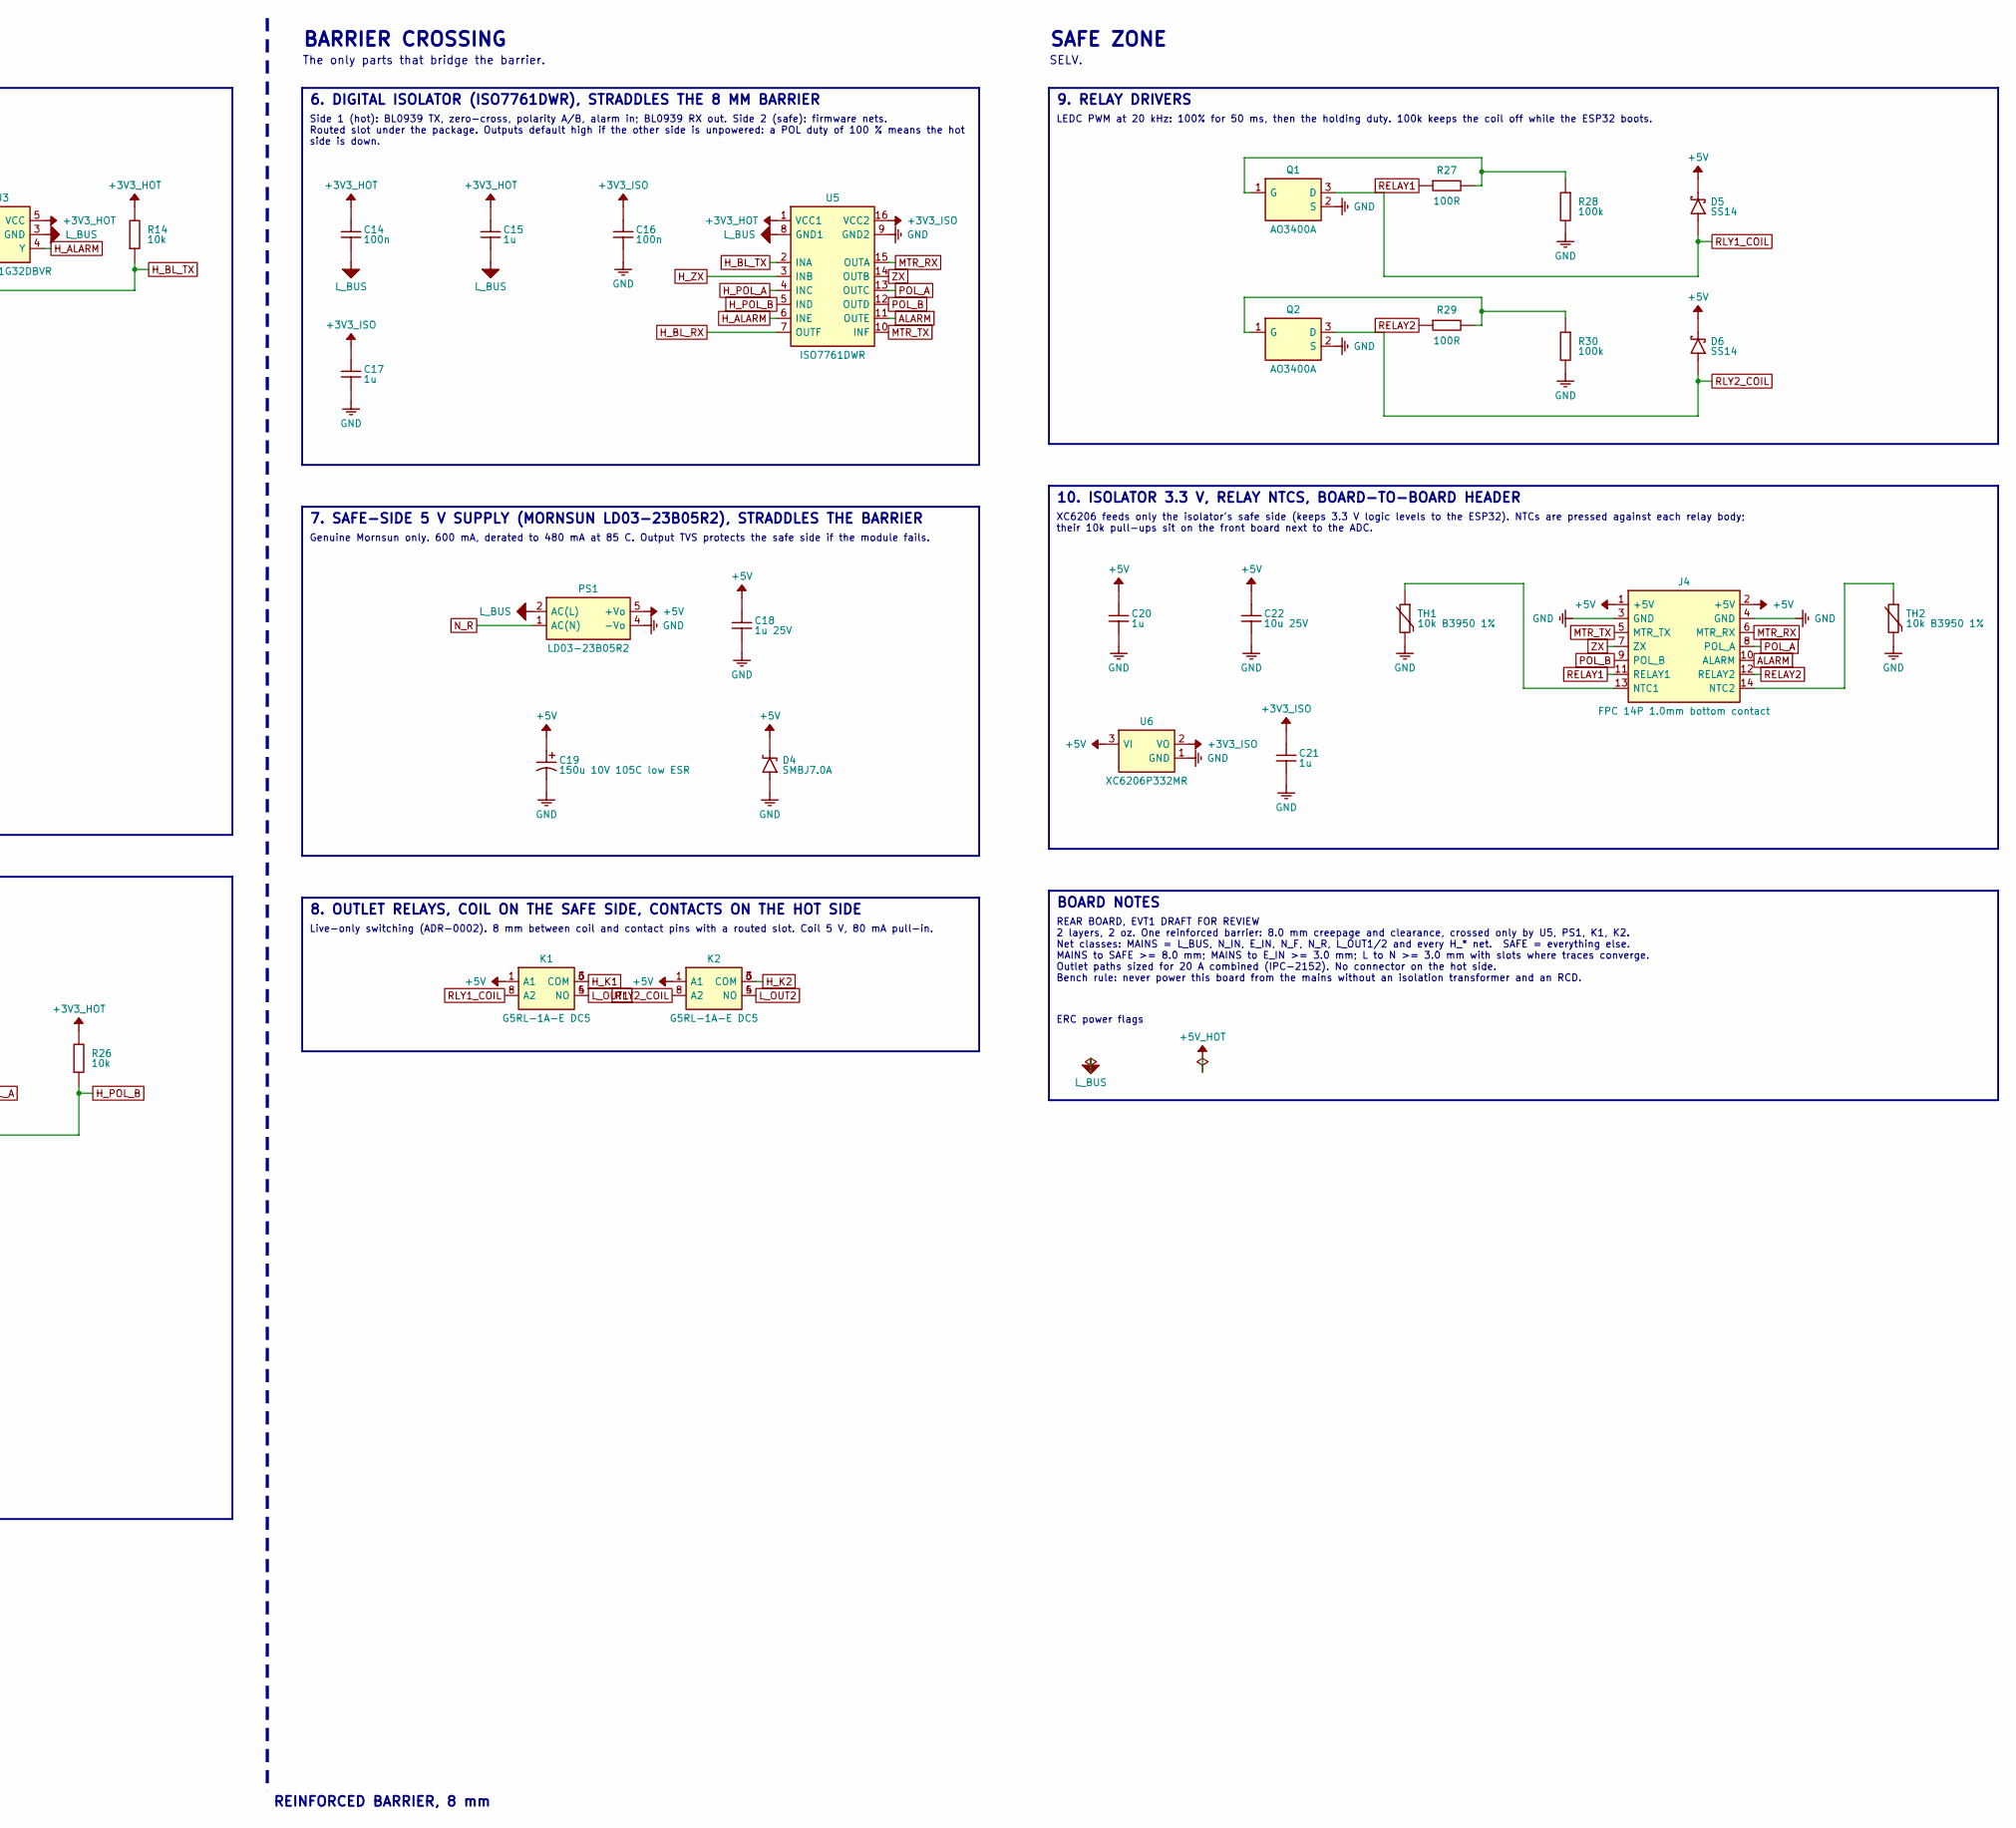
[picture p26: schematic sws-rear.kicad_sch, part in row 1, column 2]

Parts:
C1, C23: 4.7u 450V 105C 12000h; CP_Radial_D8.0mm_P3.50mm; MPN LKGD1402W4R7MF; LCSC C22391567
C2, C5, C22, C25: 10u 25V; C_0805_2012Metric; LCSC C15850
C3, C4, C11, C13, C14, C16: 100n; C_0603_1608Metric; LCSC C14663
C6, C7, C8, C9, C10: 33n X7R; C_0603_1608Metric; MPN CL10B333KB8NNNC; LCSC C21117
C15, C17, C20, C21, C27: 1u; C_0603_1608Metric; LCSC C15849
C18: 1u 25V; C_0805_2012Metric; MPN CL21B105KAFNNNE; LCSC C116352
C19: 150u 10V 105C low ESR; CP_Elec_6.3x5.8; MPN EEE-FK1A151P; LCSC C264054
C24: 1u 16V; C_0603_1608Metric; LCSC C15849
C26: 100u 16V 105C; CP_Elec_6.3x5.8; MPN EEE-FK1C101P; LCSC C128532
D1, D8, D10: M7 1000V 1A; D_SMA; MPN M7; LCSC C95872
D2: BZT52C5V1; D_SOD-123; MPN BZT52C5V1; LCSC C2117
D3: BAS116; SOT-23; MPN BAS116,215; LCSC C48502
D4: SMBJ7.0A; D_SMB; MPN SMBJ7.0A-TP; LCSC C669050
D5, D6: SS14; D_SMA; MPN SS14; LCSC C2480
D9: ES1J 600V 35ns; D_SMA; MPN ES1J; LCSC C412438
F1: 1A T 277VAC 1500A HBC; Fuse_Schurter_UMT-H; MPN 3403.0274.23
J1: Mains terminal L/N/E; Mains_Terminal_3x2.5mm2; MPN Mains terminal L/N/E
J2: Outlet 1 contacts; BS1363_Outlet_Contacts; MPN Outlet 1 contacts
J3: Outlet 2 contacts; BS1363_Outlet_Contacts; MPN Outlet 2 contacts
J4: FPC 14P 1.0mm bottom contact; TE_1-84952-4_1x14-1MP_P1.0mm_Horizontal; MPN 1-84952-4; LCSC C574848
K1, K2: G5RL-1A-E DC5; Relay_Omron_G5RL-1A-E; MPN G5RL-1A-E DC5; LCSC C397237
L1, L2: 1mH 0.36A; L_Radial_D8.7mm_P5.00mm_Fastron_07HCP; MPN VLU0810-102K; LCSC C72626
NT1, NT3: Kelvin -; NetTie-2_SMD_Pad0.5mm
NT2, NT4: Kelvin +; NetTie-2_SMD_Pad0.5mm
PS1: LD03-23B05R2; Mornsun_LD03-23B; MPN LD03-23B05R2
Q1, Q2: AO3400A; SOT-23; MPN AO3400A; LCSC C20917
R1: 12R 3W wirewound; R_Axial_DIN0617_L17.0mm_D6.0mm_P20.32mm_Horizontal; MPN KNP3W-12R-5%
R2: 47R 2W fusible wirewound; R_Axial_DIN0617_L17.0mm_D6.0mm_P20.32mm_Horizontal; MPN FW20A47R0JA
R3, R4, R5, R6, R13: 1k; R_0603_1608Metric; LCSC C21190
R7, R8, R9, R10, R11: 390k 1% 1206 500V; R_1206_3216Metric; MPN KTR18EZPF3903; LCSC C307946
R12: 470R 1%; R_0603_1608Metric; MPN 0603WAF4700T5E; LCSC C23179
R14, R25, R26, R31, R32: 10k; R_0603_1608Metric; LCSC C25804
R15, R16, R18, R19: 2M VR37 3.5kV; R_Axial_DIN0411_L9.9mm_D3.6mm_P12.70mm_Horizontal; MPN VR37000002004FA100
R17, R20: 47k 1%; R_0603_1608Metric; MPN 0603WAF4702T5E; LCSC C25819
R21: 470k 1%; R_0603_1608Metric; MPN 0603WAF4703T5E; LCSC C23178
R22: 182k 1%; R_0603_1608Metric; MPN 0603WAF1823T5E; LCSC C22894
R23: 100k 1%; R_0603_1608Metric; MPN 0603WAF1003T5E; LCSC C25803
R24: 49.9k 1%; R_0603_1608Metric; MPN 0603WAF4992T5E; LCSC C23184
R27, R29: 100R; R_0603_1608Metric; LCSC C22775
R28, R30: 100k; R_0603_1608Metric; LCSC C25803
R35: 3.09k 1%; R_0603_1608Metric; MPN CRCW06033K09FKEA; LCSC C843947
R36: 2.49k 0.5%; R_0603_1608Metric; MPN 0603WAD2491T5E; LCSC C407609
R37: 2.4k (DNP); R_0603_1608Metric; not fitted
RS1, RS2: 1m 1% 5W metal element; R_2512_6332Metric; MPN CSS2H-2512R-1L00F; LCSC C4175647
RV1: MOV 561K 10mm; RV_Disc_D12mm_W4.2mm_P7.5mm; MPN MOV-10D561K; LCSC C3263770
TF1, TF2: TCO 15A 250V; TCO_Axial_15A
TH1, TH2: 10k B3950 1%; R_0603_1608Metric; MPN CMFA103F3950HANT; LCSC C47118797
U1: LNK3204D; PowerIntegrations_SO-8C; MPN LNK3204D-TL
U2: BL0939; SSOP-20_3.9x8.7mm_P0.635mm; MPN BL0939; LCSC C2841044
U3: SN74LVC1G32DBVR; SOT-23-5; MPN SN74LVC1G32DBVR; LCSC C10096
U4: LMV393IDR; SOIC-8_3.9x4.9mm_P1.27mm; MPN LMV393IDR; LCSC C7984
U5: ISO7761DWR; SOIC-16W_7.5x10.3mm_P1.27mm; MPN ISO7761DWR; LCSC C2871529
U6, U7: XC6206P332MR; SOT-23; MPN XC6206P332MR; LCSC C5446

Connections:
+3V3_HOT: C2.1, C3.1, C4.1, C5.1, C11.1, C13.1, C14.1, C15.1, R14.2, R22.1, R25.2, R26.2, U2.1 (VDD), U2.9 (A1), U2.11 (A3), U3.5 (VCC), U4.8 (V+), U5.1 (VCC1), U7.2 (VO)
+3V3_ISO: C16.1, C17.1, C21.1, U5.16 (VCC2), U6.2 (VO)
+5V: C18.1, C19.1, C20.1, C22.1, D4.1, D5.1, D6.1, J4.1 (+5V), J4.2 (+5V), K1.1 (A1), K2.1 (A1), PS1.5 (+Vo), U6.3 (VI)
+5V_HOT: C26.1, C27.1, D10.2, L2.2, R37.1, U7.3 (VI)
ALARM: J4.10 (ALARM), U5.11 (OUTE)
E_IN: J1.3 (E), J2.3 (E), J3.3 (E), R15.1, R18.1
GND: C16.2, C17.2, C18.2, C19.2, C20.2, C21.2, C22.2, D4.2, J4.3 (GND), J4.4 (GND), PS1.4 (-Vo), Q1.2 (S), Q2.2 (S), R28.2, R30.2, TH1.2, TH2.2, U5.9 (GND2), U6.1 (GND)
H_ALARM: U3.4 (Y), U5.6 (INE)
H_BL_RX: U2.18 (RX/SDI), U5.7 (OUTF)
H_BL_TX: R14.1, U2.19 (TX/SDO), U5.2 (INA)
H_K1: K1.3 (COM), K1.6 (COM), TF1.2
H_K2: K2.3 (COM), K2.6 (COM), TF2.2
H_POL_A: R25.1, U4.1 (OUTA), U5.4 (INC)
H_POL_B: R26.1, U4.7 (OUTB), U5.5 (IND)
H_POL_INA: R31.2, U4.3 (+INA)
H_POL_X: D3.3, R21.1, R31.1, R32.1
H_S1N: NT1.2, R4.1
H_S1P: NT2.2, R3.1
H_S2N: NT3.2, R6.1
H_S2P: NT4.2, R5.1
H_SW: C24.2, C25.2, D9.1, L2.1, R36.2, U1.5 (S), U1.6 (S), U1.7 (S), U1.8 (S)
H_ZX: U2.13 (ZX), U5.3 (INB)
L_BUS: C1.2, C2.2, C3.2, C4.2, C5.2, C6.2, C7.2, C8.2, C9.2, C10.2, C11.2, C13.2, C14.2, C15.2, C23.2, C26.2, C27.2, D2.2, D9.2, J1.1 (L), NT1.1, NT3.1, PS1.2 (AC(L)), R12.2, R17.2, R21.2, R24.2, R37.2, RS1.1, RS2.1, RV1.1, U2.8 (GND), U2.10 (A2), U2.12 (A4), U2.16 (SEL), U3.3 (GND), U4.4 (GND), U5.8 (GND1), U7.1 (GND)
L_OUT1: J2.1 (L), K1.4 (NO), K1.5 (NO)
L_OUT2: J3.1 (L), K2.4 (NO), K2.5 (NO)
MTR_RX: J4.6 (MTR_RX), U5.15 (OUTA)
MTR_TX: J4.5 (MTR_TX), U5.10 (INF)
N_F: F1.2, R1.1, R2.1, R7.1, R20.2, RV1.2
N_IN: F1.1, J1.2 (N), J2.2 (N), J3.2 (N)
N_R: PS1.1 (AC(N)), R1.2
unnamed: C1.1, D8.1, L1.1
unnamed: C6.1, R3.2, U2.3 (IP1)
unnamed: C7.1, R4.2, U2.4 (IN1)
unnamed: C8.1, R5.2, U2.5 (IP2)
unnamed: C9.1, R6.2, U2.6 (IN2)
unnamed: C10.1, R13.2, U2.7 (VP)
unnamed: C23.1, L1.2, U1.4 (D)
unnamed: C24.1, U1.1 (BP/M)
unnamed: C25.1, D10.1, R35.1
unnamed: D1.1, D8.2
unnamed: D1.2, R2.2
unnamed: D2.1, D3.1, R16.2, R17.1
unnamed: J4.13 (NTC1), TH1.1
unnamed: J4.14 (NTC2), TH2.1
unnamed: NT2.1, RS1.2, TF1.1
unnamed: NT4.1, RS2.2, TF2.1
unnamed: Q1.1 (G), R27.2, R28.1
unnamed: Q2.1 (G), R29.2, R30.1
unnamed: R7.2, R8.1
unnamed: R8.2, R9.1
unnamed: R9.2, R10.1
unnamed: R10.2, R11.1
unnamed: R11.2, R12.1, R13.1
unnamed: R15.2, R16.1
unnamed: R18.2, R19.1
unnamed: R19.2, R20.1
unnamed: R22.2, R23.1, U4.2 (-INA)
unnamed: R23.2, R24.1, U4.6 (-INB)
unnamed: R32.2, U4.5 (+INB)
unnamed: R35.2, R36.1, U1.2 (FB)
unnamed: U2.14 (I_LEAK), U3.2 (B)
unnamed: U2.15 (CF), U3.1 (A)
POL_A: J4.8 (POL_A), U5.13 (OUTC)
POL_B: J4.9 (POL_B), U5.12 (OUTD)
RELAY1: J4.11 (RELAY1), R27.1
RELAY2: J4.12 (RELAY2), R29.1
RLY1_COIL: D5.2, K1.8 (A2), Q1.3 (D)
RLY2_COIL: D6.2, K2.8 (A2), Q2.3 (D)
ZX: J4.7 (ZX), U5.14 (OUTB)

Notes on the sheet:
HOT SIDE
Mains referenced. Hot-side ground = L_BUS = LIVE.
HOT SIDE, SENSING
Metering and wiring checks, all mains referenced.
BARRIER CROSSING
The only parts that bridge the barrier.
SAFE ZONE
SELV.
REINFORCED BARRIER, 8 mm
1. MAINS ENTRY AND OUTLET FEEDS
Ring L/N/E land on the busbar; only outlet current passes the shunts and relays. Shunt common end = L_BUS = hot-side ground. Net ties NT1-NT4 force the IP/IN taps to start at the shunt pads (Kelvin). Thermal cut-offs: non-resettable, clamped to the outlet feed near the contacts; Tf chosen after the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
2. ELECTRONICS FEED AND SURGE PROTECTION
Fuse and series resistor per Mornsun's LD03 application circuit. MOV after the fuse, thermally protected type. F1 is a 1500 A breaking-capacity fuse: if RV1 fails short, F1 must interrupt the circuit's prospective fault current.
3. HOT-SIDE SUPPLY (LNK3204 HALF-WAVE BUCK, 5 V, THEN 3.3 V)
Replaces the KP3310 (R1 study, hardware/sim/R1-study.md): half-wave charging through a surge resistor could not supply the 8-15 mA load. High-side buck referenced to L_BUS. RF 47R + 2 x M7 + pi filter (2 x 4.7 uF 450 V, 1 mH): simulated bulk/drain peak 465 V at a 4 kV surge (switch rated 725 V). Fe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
4. METERING (BL0939)
UART address 5 (A1, A3 high; A2, A4 low): the firmware sends 0x55/0xA5, which encode address 5. Divider 5 x 390k + 470R: 230 V gives 55 mV rms, 290 V gives 70 mV rms (pin limit 70 mV rms). Firmware board file: div_r_bottom = 0.47 k. Alarms: CF (channel A, MODE[12]) OR I_LEAK (channel B) -> isolator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
5. POLARITY AND EARTH CHECK (PULSE-WIDTH RATIO, S2 SCHEME F)
Arm A: E -> 2 x 2M (HV) -> sense 47k -> L_BUS. Arm B: E -> 2 x 2M (HV) + 47k -> N_F, so a missing earth floats to mid-supply. D3 (low leakage) passes the positive half-wave to R21; U4 compares it with 1.490 V (A) and 0.496 V (B). POL_A/POL_B are 50 Hz pulses. Firmware: duty d -> amplitude (TH/g + V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
6. DIGITAL ISOLATOR (ISO7761DWR), STRADDLES THE 8 MM BARRIER
Side 1 (hot): BL0939 TX, zero-cross, polarity A/B, alarm in; BL0939 RX out. Side 2 (safe): firmware nets. Routed slot under the package. Outputs default high if the other side is unpowered: a POL duty of 100 % means the hot side is down.
7. SAFE-SIDE 5 V SUPPLY (MORNSUN LD03-23B05R2), STRADDLES THE BARRIER
Genuine Mornsun only. 600 mA, derated to 480 mA at 85 C. Output TVS protects the safe side if the module fails.
8. OUTLET RELAYS, COIL ON THE SAFE SIDE, CONTACTS ON THE HOT SIDE
Live-only switching (ADR-0002). 8 mm between coil and contact pins with a routed slot. Coil 5 V, 80 mA pull-in.
9. RELAY DRIVERS
LEDC PWM at 20 kHz: 100% for 50 ms, then the holding duty. 100k keeps the coil off while the ESP32 boots.
10. ISOLATOR 3.3 V, RELAY NTCS, BOARD-TO-BOARD HEADER
XC6206 feeds only the isolator's safe side (keeps 3.3 V logic levels to the ESP32). NTCs are pressed against each relay body; their 10k pull-ups sit on the front board next to the ADC.
BOARD NOTES
REAR BOARD, EVT1 DRAFT FOR REVIEW 2 layers, 2 oz. One reinforced barrier: 8.0 mm creepage and clearance, crossed only by U5, PS1, K1, K2. Net classes: MAINS = L_BUS, N_IN, E_IN, N_F, N_R, L_OUT1/2 and every H_* net. SAFE = everything else. MAINS to SAFE >= 8.0 mm; MAINS to E_IN >= 3.0 mm; L to N >=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
ERC power flags
