Jdaniel98/smart-wall-socket/(commit log)

2026-11-10 Proto 0 firmware: portable core, ESP-IDF app, host tests, CI
    Portable core (sws_core, host-tested): BL0939 driver, cumulative energy,
    protection state machine, relay drive with zero-cross timing, on-device
    schedules, MQTT command parsing and message builders.
    ESP-IDF app for the Sonoff Dual R3 v2: control task that owns all safety
    state, metering UART, LEDC relay drive, inputs, status LED, NVS storage
    with separate heartbeat and factory partitions, MQTT over mutual TLS,
    two Matter On/Off Plug-in Unit endpoints, bench console, provisioning tool.
    [partitions.csv]
2026-11-10 Docs, protocol v0, ADRs; fix energy save, Matter sync and MQTT start races
    - docs/protocol.md: MQTT contract v0 (topics, payloads, limits, acks)
    - ADR-0001 monorepo and stack, ADR-0002 live-only switching,
    ADR-0003 Proto 0 firmware architecture
    - docs/proto0-bench-guide.md: safety rules, flashing, pairing,
    calibration, test plan T1-T12
    - Heartbeat now saves energy counters even before the clock is set
    - Matter on/off is re-sent until Matter has started
    - MQTT starts even if Wi-Fi got an IP before the handler was registered
    - Factory identity partition (fctry) and tools/provision.py
    [app.h, app_main.c, app_matter.cpp, control.c, net.c]
2026-11-10 Matter: watts, volts, amps and kWh per outlet
    Each outlet endpoint now carries the Electrical Sensor device type next to
    On/Off Plug-in Unit: Power Topology (tree), Electrical Power Measurement
    (active power, RMS voltage, RMS current, power factor) and Electrical Energy
    Measurement (cumulative imported energy).
    The control task no longer touches the Matter stack: on/off and meter
    updates are handed to the Matter thread with ScheduleWork, so a busy Matter
    stack cannot stall protection or trip the watchdog.
    [app.h, app_main.c, app_matter.cpp, control.c]
2026-11-10 EVT1 schematic draft A: rear and front boards
    Two KiCad projects generated from design data in hardware/tools,
    with a verifier that compares the kicad-cli netlist against the data
    and checks the barrier, power-source and GPIO rules.
    - BL0939 strapped to UART address 5 to match the firmware's 0x55/0xA5
    - voltage divider bottom 470 R for headroom under the 70 mV rms limit
    - ISO7761 channel map, LD03 and relays as the only barrier crossings
    - polarity/earth check per the EVT plan, with input limiting
    - ESP32-C6 GPIO map for board_evt_c6, light lines on SK6812MINI-E
    - review notes list open items, R1 (KP3310 drain vs MOV clamp) first
    [crossing.kicad_sch, hmi.kicad_sch, hot_side.kicad_sch, mcu_power.kicad_sch, safe_zone.kicad_sch, sws-front-bom-jlcpcb.csv, sws-front-bom.csv, sws-front.kicad_sch]
2026-11-10 EVT1 schematic draft B: one sheet per board, wired blocks
    Same circuit as draft A. Each board is now a single sheet of titled
    block frames in columns (hot side, barrier crossing, safe zone on the
    rear board), with nets drawn as wires by a grid router, rails as power
    symbols and inter-block signals as flags. PDFs use a paper theme.
    verify.py now matches wire-only nets by their pins, so any short,
    split or missed pin in the drawing fails the check.
    [crossing.kicad_sch, hmi.kicad_sch, hot_side.kicad_sch, mcu_power.kicad_sch, safe_zone.kicad_sch, sws-front.kicad_sch, sws-rear.kicad_sch]
2026-11-10 EVT1 schematic draft C: fuse breaking capacity, drain clamp, hysteresis, Kelvin taps
    - F1: Schurter UMT-H 1 A T, 1500 A breaking capacity (TE5 1 A breaks 25 A)
    - D7 SMCJ400A clamps the KP3310 drain; R2 value left to the R1 simulation
    - polarity comparators get ~100 mV hysteresis (R31-R34)
    - net ties NT1-NT4 force Kelvin sensing at the shunt pads
    - drawing: hot-side frames tinted, IC pins grouped, decaps beside their ICs
    [sws-front.kicad_sch, sws-rear-bom-jlcpcb.csv, sws-rear-bom.csv, sws-rear.kicad_sch]
2026-11-10 CI: verify hardware schematics on every hardware change
    Installs kicad-cli, runs hardware/tools/verify.py (netlist vs design data,
    barrier and power rules) and uploads the schematic PDFs as an artifact.
2026-11-10 R1 study: KP3310 surge vs hold-up, LNK3204 alternative
    ngspice models of the IEC 61000-4-5 combination wave, MOV, drain TVS and
    KP3310 charge path. The KP3310 cannot both survive a 2 kV surge and supply
    the hot side through half-wave charging. An LNK3204 half-wave buck input
    stage keeps the switch at 465 V for a 4 kV surge. Decision pending.
2026-11-10 EVT1 schematic draft D: LNK3204 hot-side supply (closes R1)
    Replaces the KP3310 and its drain clamp with an LNK3204D half-wave
    high-side buck (5 V, then an XC6206 to 3.3 V): 47 R fusible input,
    two M7 in series, 2 x 4.7 uF 450 V pi filter, 1 uF BP/M for the reduced
    current limit, ES1J freewheel, sampled feedback set for 5.0 V.
    [sws-front.kicad_sch, sws-rear-bom-jlcpcb.csv, sws-rear-bom.csv, sws-rear.kicad_sch]
2026-11-10 S2 study: polarity check latch, relay drive and 5 V rail
    The draft C hysteresis latches the polarity peak detector, so a socket
    with no earth reads as correct. Scheme F (pulse-width ratio normalised by
    the BL0939 mains reading, per-unit calibration) passes all corners and is
    proposed for draft E. Relay pull-in and the LD03 rail pass.
2026-11-10 EVT1 schematic draft E: pulse-width polarity check (S2 scheme F)
    Removes the peak detector and its latching hysteresis (C12, R33, R34).
    D3 is now a BAS116 low-leakage diode in series; R17/R20 47k, R21 470k,
    threshold ladder 182k/100k/49.9k. POL_A/POL_B carry 50 Hz pulses that
    firmware times and normalises by the BL0939 mains reading. D3 decided:
    no earth warns, swapped L/N keeps the outlets off. Layout helper now
    reads two-pin numbers from the symbol (SOT-23 diode).
    [sws-front.kicad_sch, sws-rear-bom-jlcpcb.csv, sws-rear-bom.csv, sws-rear.kicad_sch]
2026-11-10 EVT1: part numbers, pinout checks, relay and ESP32 footprints
    Every BOM line now has an LCSC number or a stated source. QT1011 strapped
    to Fast mode; NT3H2111 and LNK3204D pinouts confirmed against the
    manufacturer datasheets. Relay symbol uses Omron G5RL-1A-E pinning
    (coil 1/8, COM 3+6, NO 4+5) with a footprint that also takes the Hongfa
    HF115F; ESP32-C6-MINI-1 footprint imported from Espressif.
    [sws-front-bom-jlcpcb.csv, sws-front-bom.csv, sws-front.kicad_sch, sws-rear-bom-jlcpcb.csv, sws-rear-bom.csv, sws-rear.kicad_sch]
2026-11-10 EVT1: UMT-H, LD03 and SK6812MINI-E footprints
    Fuse_Schurter_UMT-H from Schurter's land (3.75 x 5.6 pads, 10.0 gap).
    Mornsun_LD03-23B on the 2.54 grid, pin positions from two built designs.
    LED_SK6812MINI-E_Reverse with a 3.6 x 3.2 cutout, R0.5 corners.
    Footprint tstamps are now deterministic.
2026-11-10 EVT1 layout and enclosure plan v0.1 (for sign-off)
2026-11-10 Concept renders from the layout plan; ESP32 moves to the front board's back face
2026-11-10 Layout and enclosure plan signed off; donor socket checklist
2026-11-10 Concept renders v2: FFC link, inner frame, terminal block; ESP32 to bottom centre
2026-11-10 Ray-traced exploded concept render (Blender Cycles)
2026-11-10 Concept renders with generic components (exploded, board, line art)
2026-11-11 EVT1 draft F: board link becomes a 14-way 1.0 mm FFC (J4/J101 TE 1-84952-4)
    [sws-front-bom-jlcpcb.csv, sws-front-bom.csv, sws-front.kicad_sch, sws-rear-bom-jlcpcb.csv, sws-rear-bom.csv, sws-rear.kicad_sch]
2026-11-11 EVT1 enclosure v0.1 and board outlines v0.1 from one parameter file
    params.py: shared dimensions with status tags, stack-up, fit and zoning checks (CI).
    enclosure.py: faceplate, inner frame, placeholder carriers, light guides, rear cover;
    STEP/STL and an interference check. outlines.py: both .kicad_pcb boards with outlines,
    mounting holes, rule areas and mechanical/zoning/height drawings. Ray-traced renders.
    Zoning v0: T-shaped safe island, relays lying in the bottom strip, U5 on the B side.
    [assembly_evt1_v0.1.step, carrier_left.step, carrier_left.stl, carrier_right.step, carrier_right.stl, faceplate.step, faceplate.stl, inner_frame.step]
2026-11-11 Schematic generator merges the .kicad_pro instead of overwriting the board settings
2026-11-11 Board outline v0.1 previews
